rhit-gardneml/Macrophthalmus/Tests/VoltageCONTROLLEDOscilator/vco.jpg

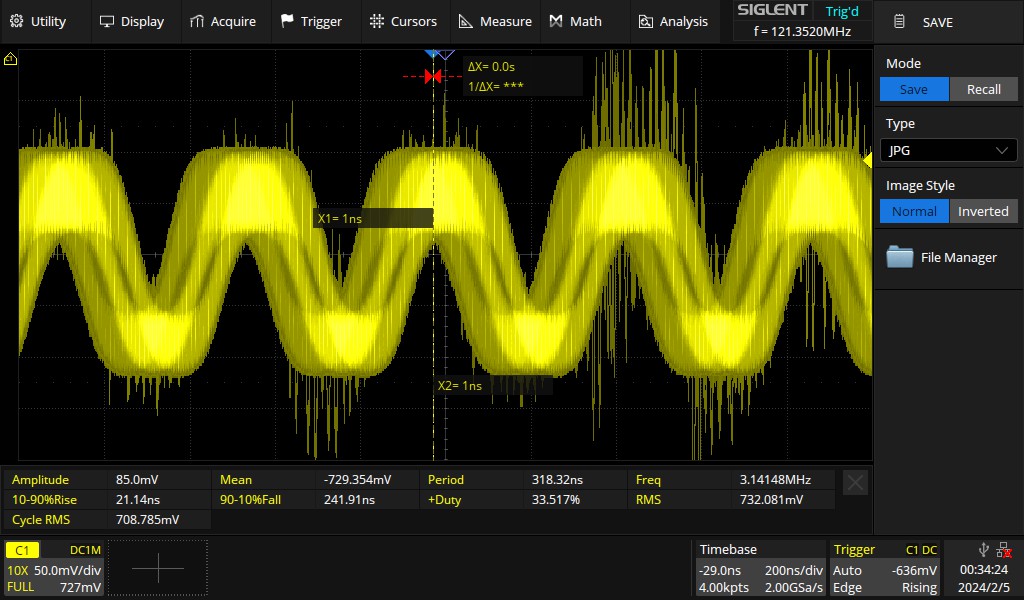
Tests/VoltageCONTROLLEDOscilator/vco.jpg
