rhit-gardneml/Macrophthalmus/Tests/VoltageCONTROLLEDOscilator/vcoeye1.jpg

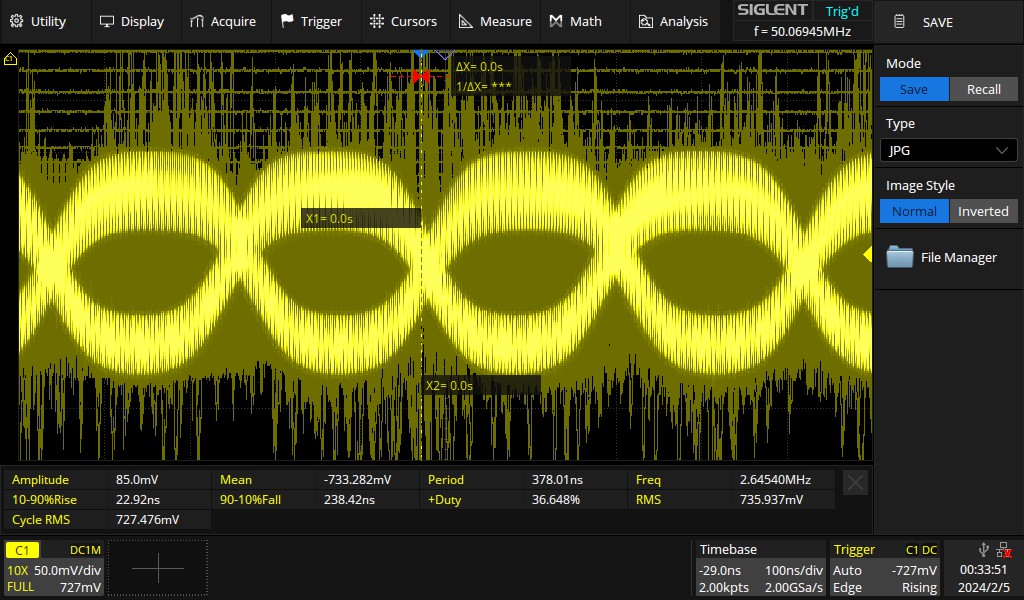
Tests/VoltageCONTROLLEDOscilator/vcoeye1.jpg
