rhit-gardneml/Macrophthalmus/README.md

"# Macrophthalmus"
This is an ece capstone team at rose-hulman makeing a communication module for LEO communication 

Remember to pull before you start working!
