rhit-gardneml/Macrophthalmus/FPGA-Code/UART_FPGA/UARTTypewriter/UartTyperwriter2023fall.runs/impl_1/.init_design.begin.rst

<?xml version="1.0"?>
<ProcessHandle Version="1" Minor="0">
    <Process Command=".planAhead." Owner="hoatsosa" Host="RHIT-R90Y2R7E" Pid="17892">
    </Process>
</ProcessHandle>
