rhit-gardneml/Macrophthalmus/FPGA-Code/QPSK_TxRx/QPSK_TxRx.runs/synth_1/.vivado.begin.rst

<?xml version="1.0"?>
<ProcessHandle Version="1" Minor="0">
    <Process Command="vivado.bat" Owner="lamy1" Host="RHIT-R90Y2R7F" Pid="9360" HostCore="12" HostMemory="016935268352">
    </Process>
</ProcessHandle>
