rhit-gardneml/Macrophthalmus/FPGA-Code/BPSK_modulation/BPSK_modulation/BPSK_modulation.runs/synth_1/.vivado.begin.rst

<?xml version="1.0"?>
<ProcessHandle Version="1" Minor="0">
    <Process Command="vivado.bat" Owner="robinsvs" Host="RHIT-R90Y2R1M" Pid="24328" HostCore="12" HostMemory="016936722432">
    </Process>
</ProcessHandle>
