rhit-gardneml/Macrophthalmus/FPGA-Code/UART_FPGA/UARTTypewriter/UartTyperwriter2023fall.runs/impl_1/.vivado.begin.rst

<?xml version="1.0"?>
<ProcessHandle Version="1" Minor="0">
    <Process Command="vivado.bat" Owner="hoatsosa" Host="RHIT-R90Y2R7E" Pid="26004" HostCore="12" HostMemory="016901607424">
    </Process>
</ProcessHandle>
