rhit-gardneml/Macrophthalmus/VCO/tek00000.png

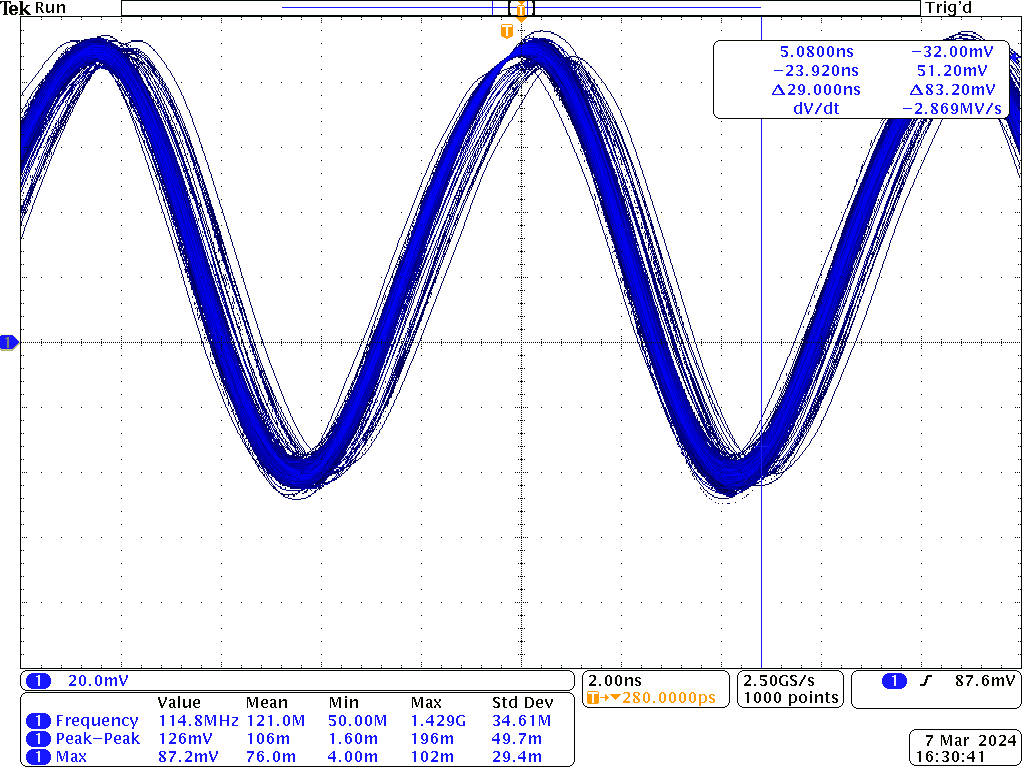
VCO/tek00000.png
