rhit-gardneml/Macrophthalmus/Datasheets and other resources/BOM.xlsx

Sheet: Total BOM
Item | Amount | Link | Part number | Cost | Shipping | Tax | Total Cost | Total
Radiation Hardened 14-Bit 1MSPS SAR ADC | 1 | https://www.renesas.com/us/en/document/dst/isl73141seh-datasheet?r=1399891 | ISL73141SEH | $0.00 |  |  | $0.00 | $1533.42
80MHz Arm M0+ MCU, 128KB Flash, 32KB SRAM, 2×12bit 4Msps ADC, DAC, 3×COMP, 3×op-amp, CAN-FD, MATHACL | 5 | https://www.ti.com/product/MSPM0G3507/part-details/XMSM0G3507SPT | XMSM0G3507SPT | $2.04 | 12 | $0.98 | $23.18
MSPM0G3507 LaunchPad™ development kit for 80-MHz Arm® Cortex®-M0+ MCU | 2 | https://www.ti.com/tool/LP-MSPM0G3507 | LP-MSPM0G3507 | $16.99 | 12 | $2.03 | $48.01
Supervisory Circuits Mil Enh Ultra-Lo Spl Current/Supply Vltg | 3 | https://www.mouser.com/ProductDetail/Texas-Instruments/TPS3106K33MDBVREP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 | TPS3106K33MDBVREP | $5.56 |  |  | $16.68
Conductive, Dissipative Table, Workbench Grounding Mat Rubber Blue 3' (0.91m) X 2' (0.61m) | 1 | https://www.digikey.com/en/products/detail/desco/66322/5822302 | 66322 | $138.53 |  |  | $138.53
Wrist Strap with Cord 6' (1.83m) One Size 1 MOhms Blue | 2 | https://www.digikey.com/en/products/detail/scs/ECWS61M-1/1621640 | ECWS61M-1 | $6.90 |  |  | $13.80
RF Amplifier LOW NOISE AMPL / SM / RoHS | 5 | https://www.mouser.com/ProductDetail/Mini-Circuits/TAV1-331%2b?qs=xZ%2FP%252Ba9zWqaQDud4ssIjbQ%3D%3D | TAV1-331+ | $1.89 |  |  | $9.45
RF Mixer Level 7, SMT High Reliability, RF/LO Freq 300 - 2400 MHz | 5 | https://www.mouser.com/ProductDetail/Mini-Circuits/MAC-24%2B?qs=Imq1NPwxi77%252B9Qt5S4nmTg%3D%3D | MAC-24+ | $33.08 |  |  | $165.40
EVAL BOARD FOR MAC-24+ | 1 | https://www.minicircuits.com/WebStore/dashboard.html?model=MAC-24%2B | TB-MAC-24+ | $146.90 |  |  | $146.90
TEST BOARD FOR TAV1-331+ | 1 | https://www.minicircuits.com/WebStore/dashboard.html?model=TAV1-331%2B | TB-TAV1-331+ | $175.95 |  |  | $175.95
FPGA - Field Programmable Gate Array XA7A100T-1CSG324Q | 4 | https://www.mouser.com/ProductDetail/Xilinx/XA7A100T-1CSG324Q?qs=rrS6PyfT74dDWxqUmFgR8Q%3D%3D | XA7A100T-1CSG324Q | $198.88 |  |  | $795.52
VCO Oscillators BBG ECL Low PWR VCO | 3 | https://www.mouser.com/ProductDetail/onsemi/MC100EL1648DG?qs=sGAEpiMZZMtldj7qu1ydrXz30ua73QtvI4PIjSlVPMs%3D | MC100EL1648DG | $11.89 |  |  | $35.67
 |  |  |  |  |  |  | $0.00
 |  |  |  |  |  |  | $0.00
 |  |  |  |  |  |  | $0.00
 |  |  |  |  |  |  | $0.00
 |  |  |  |  |  |  | $0.00
 |  |  |  |  |  |  | $0.00
 |  |  |  |  |  |  | $0.00
 |  |  |  |  |  |  | $0.00
 |  |  |  |  |  |  | $0.00
 |  |  |  |  |  |  | $0.00
 |  |  |  |  |  |  | $0.00
 |  |  |  |  |  |  | $0.00
 |  |  |  |  |  |  | $0.00
 |  |  |  |  |  |  | $0.00
 |  |  |  |  |  |  | $0.00
 |  |  |  |  |  |  | $0.00
 |  |  |  |  |  |  | $0.00
 |  |  |  |  |  |  | $0.00
 |  |  |  |  |  |  | $0.00
 |  |  |  |  |  |  | $0.00
 |  |  |  |  |  |  | $0.00
 |  |  |  |  |  |  | $0.00
 |  |  |  |  |  |  | $0.00
 |  |  |  |  |  |  | $0.00
 |  |  |  |  |  |  | $0.00
 |  |  |  |  |  |  | $0.00
 |  |  |  |  |  |  | $0.00
 |  |  |  |  |  |  | $0.00
 |  |  |  |  |  |  | $0.00
 |  |  |  |  |  |  | $0.00
 |  |  |  |  |  |  | $0.00
 |  |  |  |  |  |  | $0.00
 |  |  |  |  |  |  | $0.00
 |  |  |  |  |  |  | $0.00
 |  |  |  |  |  |  | $0.00
 |  |  |  |  |  |  | $0.00
 |  |  |  |  |  |  | $0.00
 |  |  |  |  |  |  | $0.00
 |  |  |  |  |  |  | $0.00
 |  |  |  |  |  |  | $0.00
 |  |  |  |  |  |  | $0.00
 |  |  |  |  |  |  | $0.00
 |  |  |  |  |  |  | $0.00
 |  |  |  |  |  |  | $0.00
 |  |  |  |  |  |  | $0.00
 |  |  |  |  |  |  | $0.00
 |  |  |  |  |  |  | $0.00
 |  |  |  |  |  |  | $0.00
 |  |  |  |  |  |  | $0.00
 |  |  |  |  |  |  | $0.00
 |  |  |  |  |  |  | $0.00
 |  |  |  |  |  |  | $0.00
 |  |  |  |  |  |  | $0.00
 |  |  |  |  |  |  | $0.00
 |  |  |  |  |  |  | $0.00
 |  |  |  |  |  |  | $0.00
 |  |  |  |  |  |  | $0.00
 |  |  |  |  |  |  | $0.00
 |  |  |  |  |  |  | $0.00
 |  |  |  |  |  |  | $0.00
 |  |  |  |  |  |  | $0.00
 |  |  |  |  |  |  | $0.00
 |  |  |  |  |  |  | $0.00
 |  |  |  |  |  |  | $0.00
 |  |  |  |  |  |  | $0.00
 |  |  |  |  |  |  | $0.00
 |  |  |  |  |  |  | $0.00
 |  |  |  |  |  |  | $0.00
 |  |  |  |  |  |  | $0.00
 |  |  |  |  |  |  | $0.00
 |  |  |  |  |  |  | $0.00
 |  |  |  |  |  |  | $0.00
 |  |  |  |  |  |  | $0.00
 |  |  |  |  |  |  | $0.00
 |  |  |  |  |  |  | $0.00
 |  |  |  |  |  |  | $0.00
 |  |  |  |  |  |  | $0.00
 |  |  |  |  |  |  | $0.00
 |  |  |  |  |  |  | $0.00
 |  |  |  |  |  |  | $0.00
 |  |  |  |  |  |  | $0.00
 |  |  |  |  |  |  | $0.00
 |  |  |  |  |  |  | $0.00
 |  |  |  |  |  |  | $0.00
 |  |  |  |  |  |  | $0.00
 |  |  |  |  |  |  | $0.00
 |  |  |  |  |  |  | $0.00

Sheet: Tim BOM
Part Description | Quantity | Part URL | Part Number | Unit Price | Total | Total Overall
Supervisory Circuits Mil Enh Ultra-Lo Spl Current/Supply Vltg | 3 | https://www.mouser.com/ProductDetail/Texas-Instruments/TPS3106K33MDBVREP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 | TPS3106K33MDBVREP | $5.56 | $16.68 | $666.71
Conductive, Dissipative Table, Workbench Grounding Mat Rubber Blue 3' (0.91m) X 2' (0.61m) | 1 | https://www.digikey.com/en/products/detail/desco/66322/5822302 | 66322 | $138.53 | $138.53
Wrist Strap with Cord 6' (1.83m) One Size 1 MOhms Blue | 2 | https://www.digikey.com/en/products/detail/scs/ECWS61M-1/1621640 | ECWS61M-1 | $6.90 | $13.80
RF Amplifier LOW NOISE AMPL / SM / RoHS | 5 | https://www.mouser.com/ProductDetail/Mini-Circuits/TAV1-331%2b?qs=xZ%2FP%252Ba9zWqaQDud4ssIjbQ%3D%3D | TAV1-331+ | $1.89 | $9.45
RF Mixer Level 7, SMT High Reliability, RF/LO Freq 300 - 2400 MHz | 5 | https://www.mouser.com/ProductDetail/Mini-Circuits/MAC-24%2B?qs=Imq1NPwxi77%252B9Qt5S4nmTg%3D%3D | MAC-24+ | $33.08 | $165.40
EVAL BOARD FOR MAC-24+ | 1 | https://www.minicircuits.com/WebStore/dashboard.html?model=MAC-24%2B | TB-MAC-24+ | $146.90 | $146.90
TEST BOARD FOR TAV1-331+ | 1 | https://www.minicircuits.com/WebStore/dashboard.html?model=TAV1-331%2B | TB-TAV1-331+ | $175.95 | $175.95
