rhit-gardneml/Macrophthalmus/Eval-Boards/LPF-Eval-Board/EMPCB.SMAFSTJ.B.HT.step

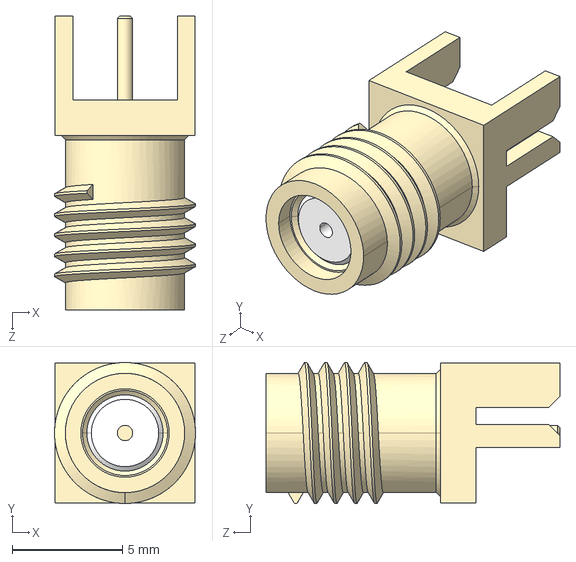
[picture p4: CAD file, 2024-01-26]
Eval-Boards/LPF-Eval-Board/EMPCB.SMAFSTJ.B.HT.step
6.38 x 6.38 x 13.3 mm
