rhit-gardneml/Macrophthalmus/Tests/ADC/DataRateCalculator - March 19.xlsx

Bandwidth / Data rate calculator
 |  |  |  |  | 32000000 | Clock
Desired Throughput | 1200 | Baud
 |  |  |  |  | 48 | Divider | 1, 2, 4, 8, 16, 32, 48
Bandwidth multiplier | 4
 | 4800 | Minimum |  |  | 666666.6667
Required Sample Rate | 5208.333333
 |  |  |  |  | 128 | Hardware downsampling
Bits Per Sample | 12 |  |  |  |  |  | 1, 2, 4, 8, 16, 32, 64, 128
 |  |  |  |  | 5208.333333 | Sample Rate
Bytes Per Sample | 2 |  |  |  | 0.0001920000 | Seconds
 |  |  |  |  | 2604.166667 | Highest Frequency Capture
Data rate | 10416.66667 | bytes per second
 |  |  |  |  | 17.8 | mS | 0.05617977528
Data rate | 83333.33333 | bits per second |  |  | 0.017800 | uS | 56.17977528
 |  |  |  |  | 9.270833333e-05
Conversion bps to baud | 0.80
 |  |  |  |  | 128 | ping
Baud to FPGA | 104166.6667 |  |  |  | 128 | pong
 | 115200 | Baud |  |  | 256 |  | 98 | ms
 | 0.0000086806 |  |  |  | 0.0492 | seconds | 3.8 | seconds
 | 0.0000868056 | 0.02222 | s | 0.01111111111 | 0.0246
 |  | 22.22222222 | ms | 11.11111111
 | 50 | uS |  |  | 0.000015729
 | 50000 | mS |  |  | 0.0157286
 | 50000000 | S
