rhit-gardneml/Macrophthalmus/Tests/ADC/DataRateCalculator.xlsx

Bandwidth / Data rate calculator
 |  |  | 32000000 | Clock
Desired Throughput | 1200 | Baud
 |  |  | 48 | Divider | 1, 2, 4, 8, 16, 32, 48
Bandwidth multiplier | 4
 | 4800 | Minimum | 666666.6667
Required Sample Rate | 5208.333333
 |  |  | 128 | Hardware downsampling
Bits Per Sample | 12 |  |  |  | 1, 2, 4, 8, 16, 32, 64, 128
 |  |  | 5208.333333 | Sample Rate
Bytes Per Sample | 2
Data rate | 10416.66667 | bytes per second
Data rate | 83333.33333 | bits per second
Conversion bps to baud | 0.80
Baud to FPGA | 104166.6667
 | 115200 | Baud
