rhit-gardneml/Macrophthalmus/Tests/Mixer/Downsample/GoodLunch.pdf

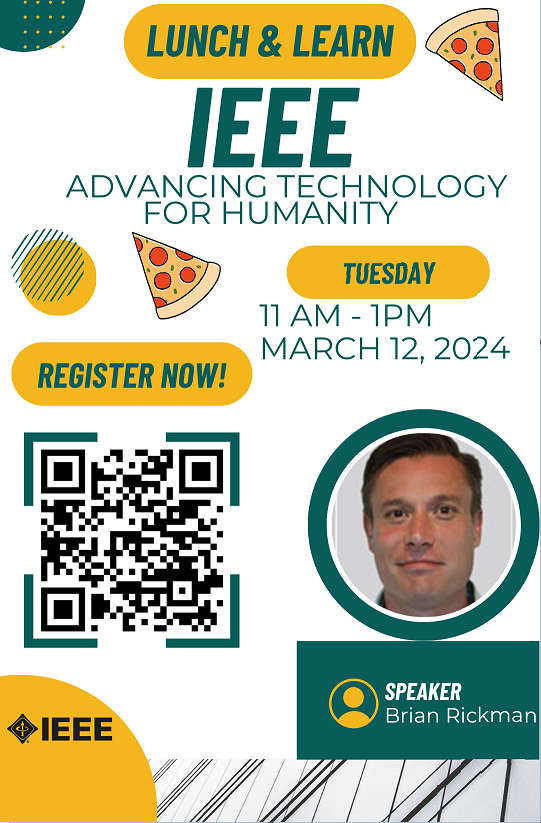
[picture p5: figure]
