rhit-gardneml/Macrophthalmus/Tests/Mar22nd/PA-Test.xlsx

Freq (MHz) | dBm before | dBm After
400 | -37 | -23
410 | -40 | -19
420 | -41 | -18
430 | -42 | -17 | 430MHz | -50
440 | -53 | -18
450 | -56 | -18
460 | -52 | -22
