rhit-gardneml/Macrophthalmus/Tests/Mixer_with_BPF/Data.xlsx

Freq in | Freq out | Freq Diff | Harm | Harm Diff | dBm in | dBm out | dBm harm | dBm diff
400 | 402 | 2 | 800 | 398 | 2.3 | -55 | -65 | -10
405 | 407 | 2 | 810 | 403 | 2.3 | -50 | -64 | -14
410 | 412 | 2 | 820 | 408 | 2.3 | -55 | -65 | -10
415 | 417 | 2 | 830 | 413 | 2.3 | -55 | -69 | -14
420 | 422 | 2 | 840 | 418 | 2.3 | -51 | -70 | -19
425 | 427 | 2 | 850 | 423 | 2.3 | -49 | -70 | -21
429 | 431 | 2 | 859 | 428 | 2.3 | -52 | -75 | -23
430 | 432 | 2 | 860 | 428 | 2.3 | -55 | -69 | -14 | *Tori Take in data and add 20 to dB
435 | 437 | 2 | 870 | 433 | 2.3 | -57 | -73 | -16
440 | 442 | 2 | 880 | 438 | 2.3 | -49 | -70 | -21
445 | 447 | 2 | 890 | 443 | 2.3 | -56 | -71 | -15
450 | 452 | 2 | 900 | 448 | 2.3 | -60 | -70 | -10
455 | 457 | 2 | 910 | 453 | 2.3 | -63 | -70 | -7
 | 800 |  |  |  |  | -65
 | 810 |  |  |  |  | -64
 | 820 |  |  |  |  | -65
 | 830 |  |  |  |  | -69
 | 840 |  |  |  |  | -70
 | 850 |  |  |  |  | -70
 | 859 |  |  |  |  | -75
 | 860 |  |  |  |  | -69
 | 870 |  |  |  |  | -73
 | 880 |  |  |  |  | -70
 | 890 |  |  |  |  | -71
 | 900 |  |  |  |  | -70
 | 910 |  |  |  |  | -70
