rhit-gardneml/Macrophthalmus/Tests/DAC/BPSK_Digital_Representation - March 19.xlsx

 | samples | time | freq | bpsk | digital1 |  | samples | time | freq | bpsk | digital0
BPSK "1" | 0 | 1e-05 | 8000 | 0.87631 | 3841.737927 | BPSK "0" | 0 | 1e-06 | 80000 | -0.9 | 204.75
1e-05 | 1 | 2e-05 | 8000 | 0.53583 | 3144.605353 |  | 1 | 2e-06 | 80000 | -0.5 | 1023.75
1e-05 | 2 | 3e-05 | 8000 | 0.06279 | 2176.06359 |  | 2 | 3e-06 | 80000 | -0.1 | 1842.75
1e-05 | 3 | 4e-05 | 8000 | -0.42578 | 1175.716904 |  | 3 | 4e-06 | 80000 | 0.4 | 2866.5
1e-05 | 4 | 5e-05 | 8000 | -0.80902 | 391.037713 |  | 4 | 5e-06 | 80000 | 0.8 | 3685.5
1e-05 | 5 | 6e-05 | 8000 | -0.99211 | 16.14515175 |  | 5 | 6e-06 | 80000 | 1.0 | 4095
1e-05 | 6 | 7e-05 | 8000 | -0.92978 | 143.7826367 |  | 6 | 7e-06 | 80000 | 0.9 | 3890.25
1e-05 | 7 | 8e-05 | 8000 | -0.63742 | 742.3743805 |  | 7 | 8e-06 | 80000 | 0.6 | 3276
1e-05 | 8 | 9e-05 | 8000 | -0.18738 | 1663.836768 |  | 8 | 9e-06 | 80000 | 0.2 | 2457
1e-05 | 9 | 0.0001 | 8000 | 0.30902 | 2680.212287 |  | 9 | 1e-05 | 80000 | -0.3 | 1433.25
1e-05 | 10 | 0.00011 | 8000 | 0.72897 | 3540.06327 |  | 10 | 1.1e-05 | 80000 | -0.7 | 614.25
1e-05 | 11 | 0.00012 | 8000 | 0.96858 | 4030.67402 |  | 11 | 1.2e-05 | 80000 | -1.0 | 0
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
