rhit-gardneml/Macrophthalmus/Tests/NewLowPass/LowPassTest.xlsx

Input Frequency | Input dBm | Output Frequency | Output dBm | Highest Harmonic | Output dBm
10000 | 3.98 | 10000 | 3.3 | 24000 | -60
20000 | 3.98 | 20000 | 3.8 | 60000 | -60
100000 | 3.98 | 100000 | 4.1 | 900000 | -75
500000 | 3.98 | 500000 | 4 | 3500000 | -70
1000000 | 0 | 1000000 | -0.3 | 300000000 | -75
2000000 | 0 | 2000000 | -0.2 | 0 | 0
3000000 | 0 | 3000000 | -0.6 | 0 | 0
4000000 | 0 | 4000000 | -12.9 | 0 | 0
5000000 | 0 | 5000000 | -42.2 | 0 | 0
10000000 | 0 | 10000000 | -58.9 | 0 | 0
