rhit-gardneml/Macrophthalmus/Tests/DAC/BPSK_Digital_Representation.xlsx

 | samples | time | freq | bpsk | digital1 |  | samples | time | freq | bpsk | digital0
BPSK "1" | 0 | 1e-06 | 20000 | 0.9921151658 | 4078.855802 | BPSK "0" | 0 | 1e-06 | 20000 | -0.9921151658 | 16.144198
 | 1 | 2e-06 | 20000 | 0.9685850045 | 4030.677797 |  | 1 | 2e-06 | 20000 | -0.9685850045 | 64.32220336
 | 2 | 3e-06 | 20000 | 0.9297805788 | 3951.225735 |  | 2 | 3e-06 | 20000 | -0.9297805788 | 143.7742649
 | 3 | 4e-06 | 20000 | 0.8763138217 | 3841.75255 |  | 3 | 4e-06 | 20000 | -0.8763138217 | 253.24745
 | 4 | 5e-06 | 20000 | 0.8090278863 | 3703.984597 |  | 4 | 5e-06 | 20000 | -0.8090278863 | 391.0154028
 | 5 | 6e-06 | 20000 | 0.7289838494 | 3540.094432 |  | 5 | 6e-06 | 20000 | -0.7289838494 | 554.9055683
 | 6 | 7e-06 | 20000 | 0.637443979 | 3352.666547 |  | 6 | 7e-06 | 20000 | -0.637443979 | 742.3334531
 | 7 | 8e-06 | 20000 | 0.5358518283 | 3144.656619 |  | 7 | 8e-06 | 20000 | -0.5358518283 | 950.3433815
 | 8 | 9e-06 | 20000 | 0.4258094721 | 2919.344894 |  | 8 | 9e-06 | 20000 | -0.4258094721 | 1175.655106
 | 9 | 1e-05 | 20000 | 0.3090522417 | 2680.284465 |  | 9 | 1e-05 | 20000 | -0.3090522417 | 1414.715535
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
