rhit-gardneml/Macrophthalmus/Tests/Mixer/Upsample/Up_Conversion_Data_mk1.xlsx

Freq in | Freq out | Freq Diff | Abs Harm BW | Harm BW | dBm in | dBm out
400 | 402 | 2 | 801 | 399 | 2.3 | -47
405 | 407 | 2 | 810 | 403 | 2.3 | -44
410 | 412 | 2 | 820 | 408 | 2.3 | -48
415 | 417 | 2 | 830 | 413 | 2.3 | -46
420 | 422 | 2 | 840 | 418 | 2.3 | -44
425 | 427 | 2 | 850 | 423 | 2.3 | -41
429 | 431 | 2 | 858 | 427 | 2.3 | -42
430 | 432 | 2 | 860 | 428 | 2.3 | -45
435 | 437 | 2 | 870 | 433 | 2.3 | -42
440 | 442 | 2 | 880 | 438 | 2.3 | -41
445 | 447 | 2 | 890 | 443 | 2.3 | -45
450 | 452 | 2 | 900 | 448 | 2.3 | -42
455 | 457 | 2 | 910 | 453 | 2.3 | -41
