rhit-gardneml/Macrophthalmus/Tests/ADC/Correct/ADC_DMA_Period.png

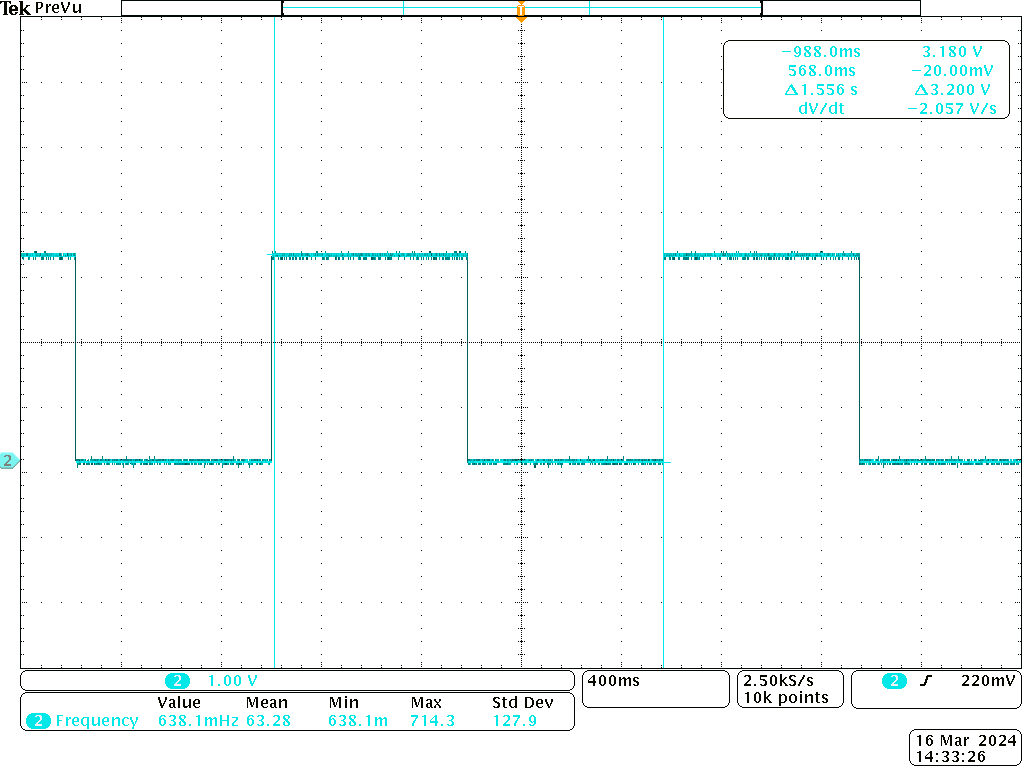
Tests/ADC/Correct/ADC_DMA_Period.png
