rhit-gardneml/Macrophthalmus/Tests/ADC/Correct/ADC_DMA_UART_Transfer.png

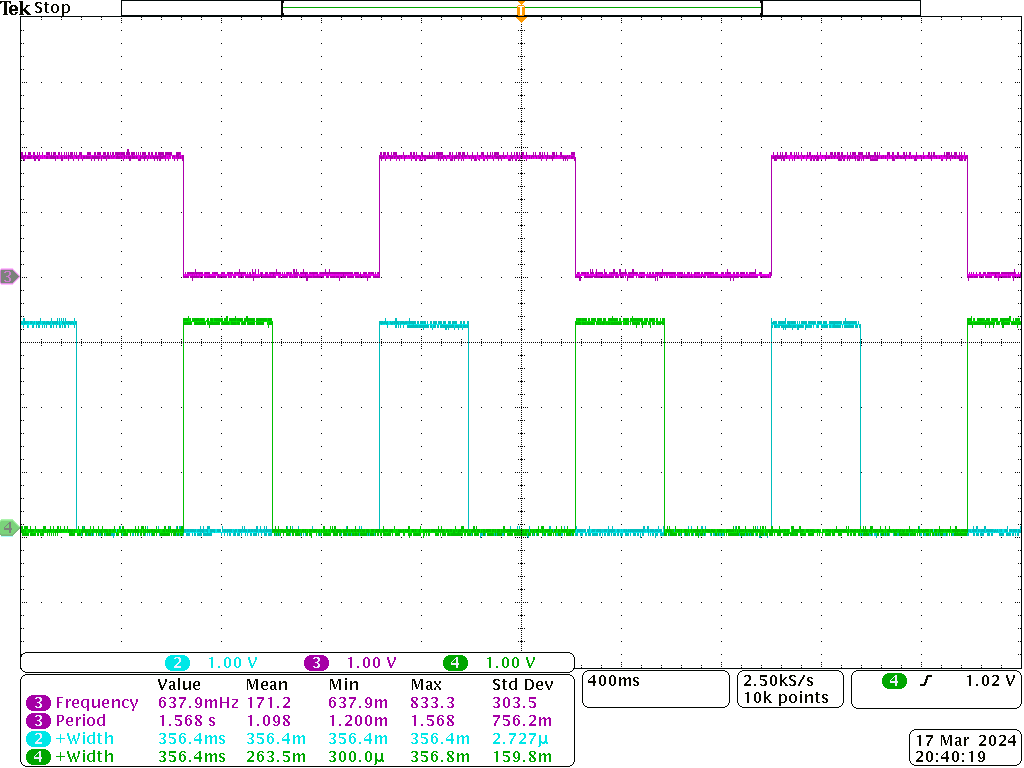
Tests/ADC/Correct/ADC_DMA_UART_Transfer.png
