rhit-gardneml/Macrophthalmus/Tests/ADC/Correct/ADC_DMA_UART_transfer_128_closeup.png

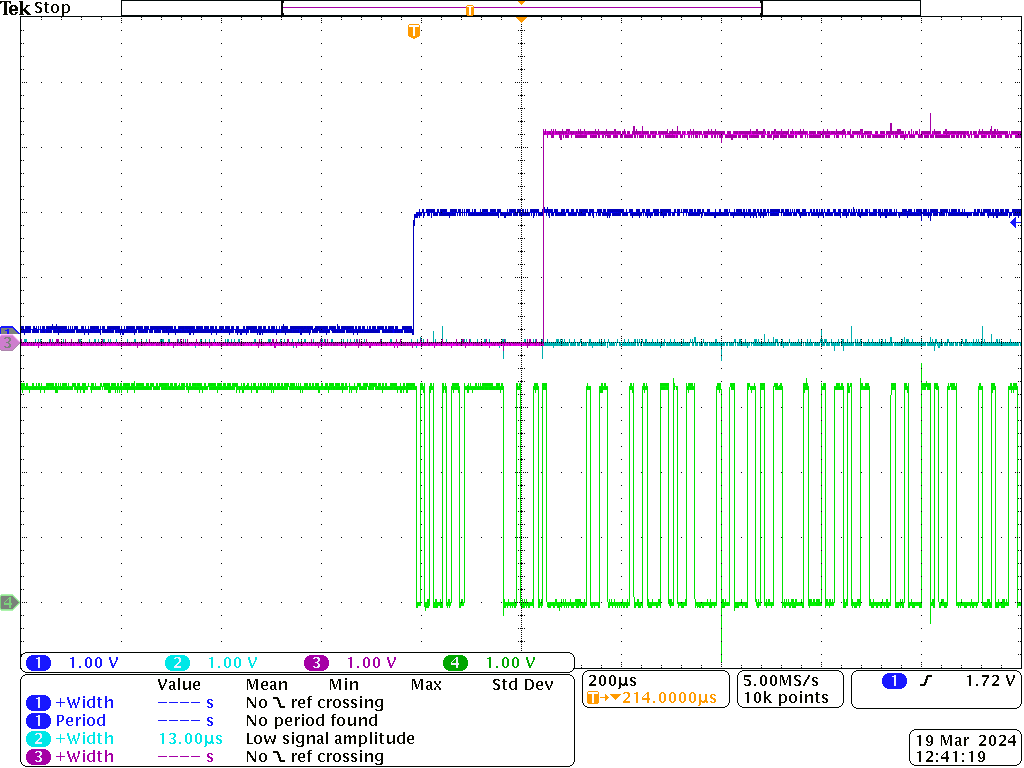
Tests/ADC/Correct/ADC_DMA_UART_transfer_128_closeup.png
