rhit-gardneml/Macrophthalmus/Tests/ADC/Correct/ADC_DMA_UART_Transfer_128samples.png

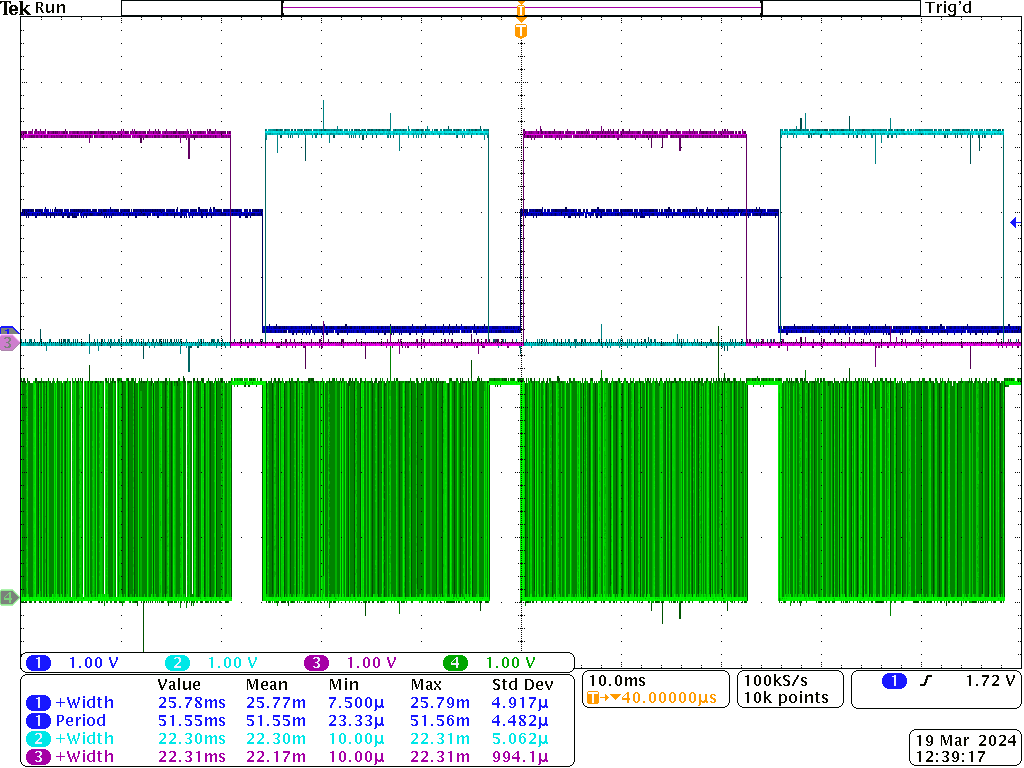
Tests/ADC/Correct/ADC_DMA_UART_Transfer_128samples.png
