rhit-gardneml/Macrophthalmus/Tests/ADC/Incorrect/ADC_1MHz^PSK.png

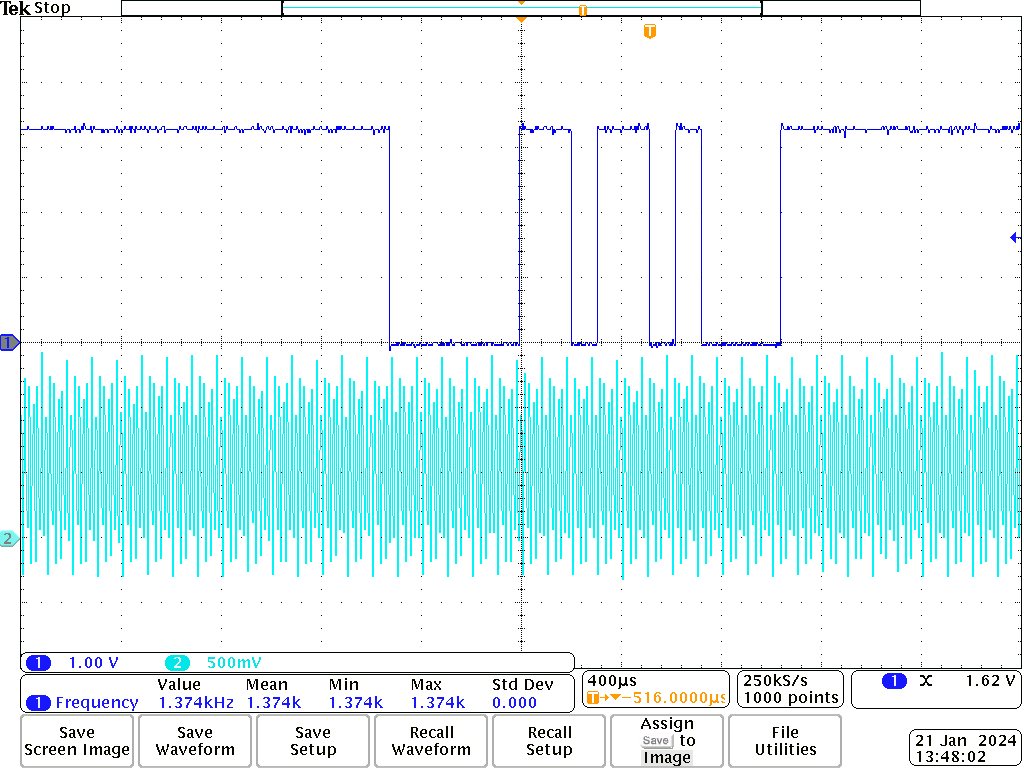
Tests/ADC/Incorrect/ADC_1MHz^PSK.png
