rhit-gardneml/Macrophthalmus/Tests/ADC/Incorrect/tek00066.png

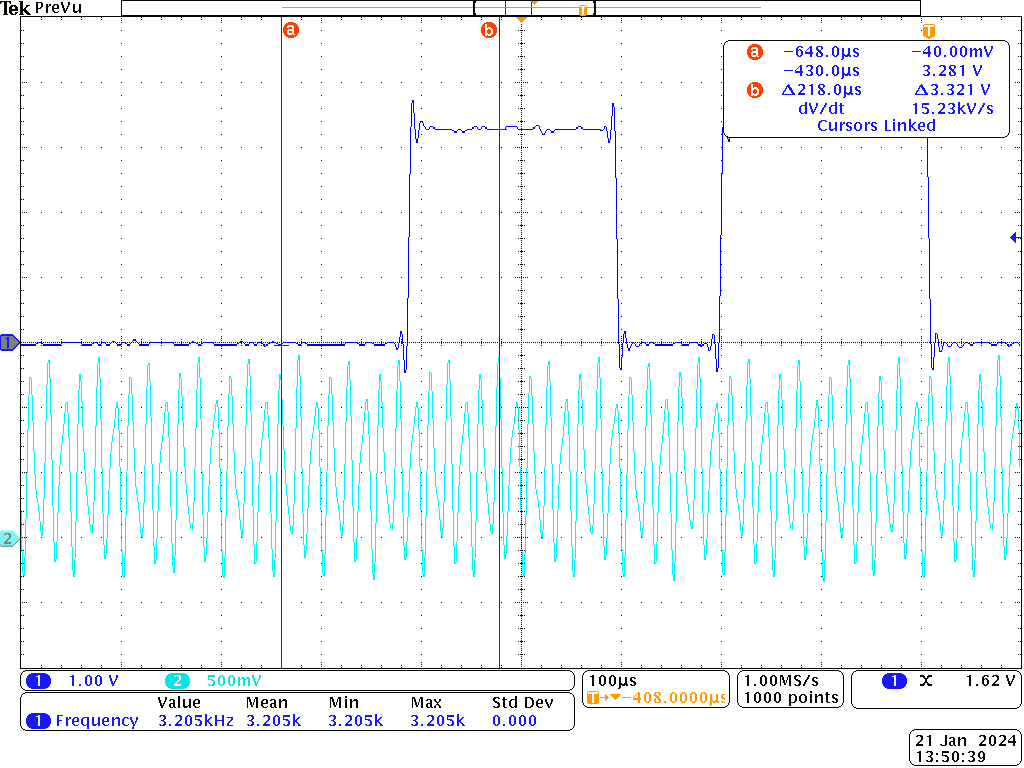
Tests/ADC/Incorrect/tek00066.png
