rhit-gardneml/Macrophthalmus/Tests/ADC/Incorrect/tek00067.png

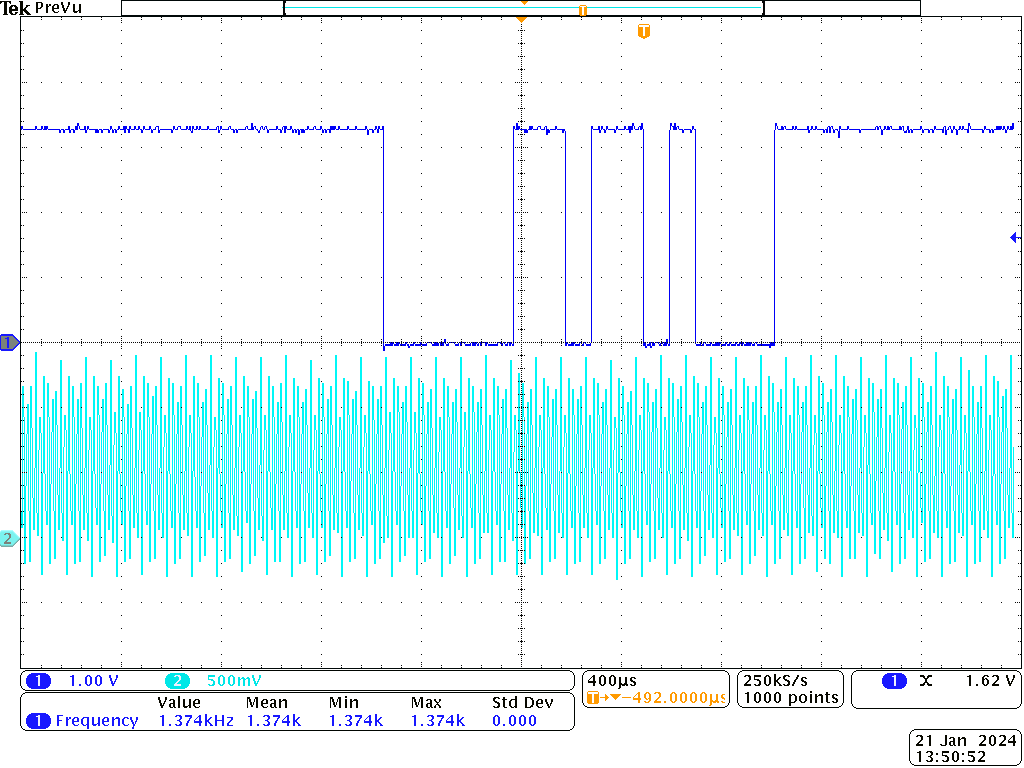
Tests/ADC/Incorrect/tek00067.png
