rhit-gardneml/Macrophthalmus/Tests/ADC/Incorrect/tek00068.png

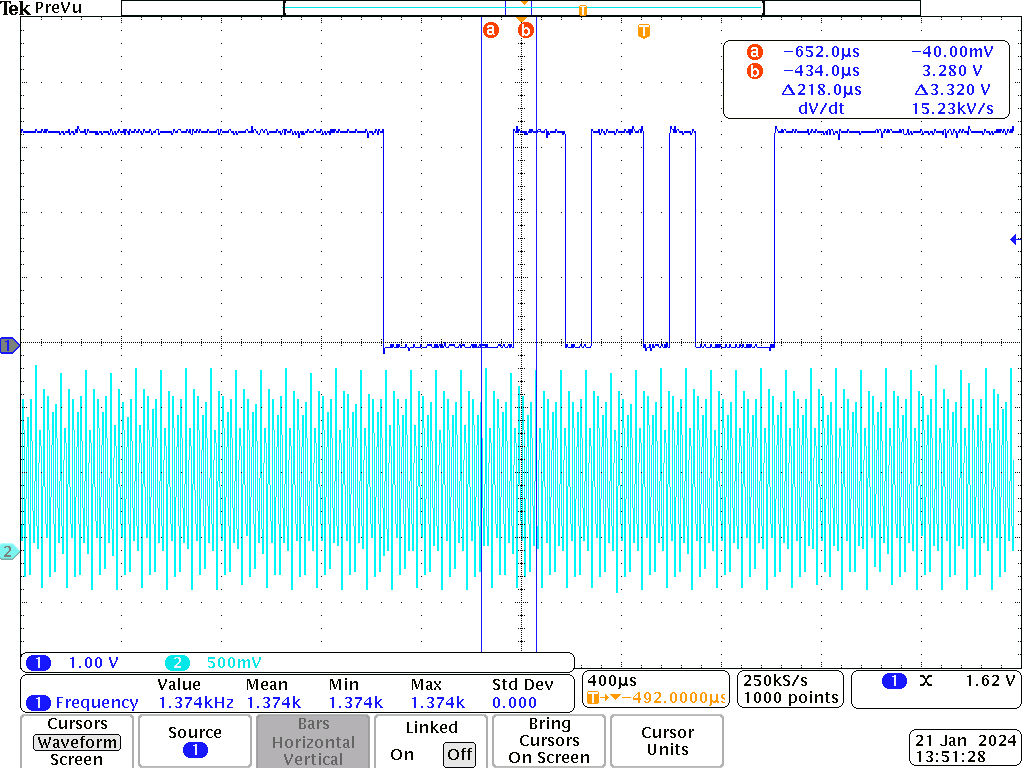
Tests/ADC/Incorrect/tek00068.png
