rhit-gardneml/Macrophthalmus/Tests/DAC/DAC100k.png

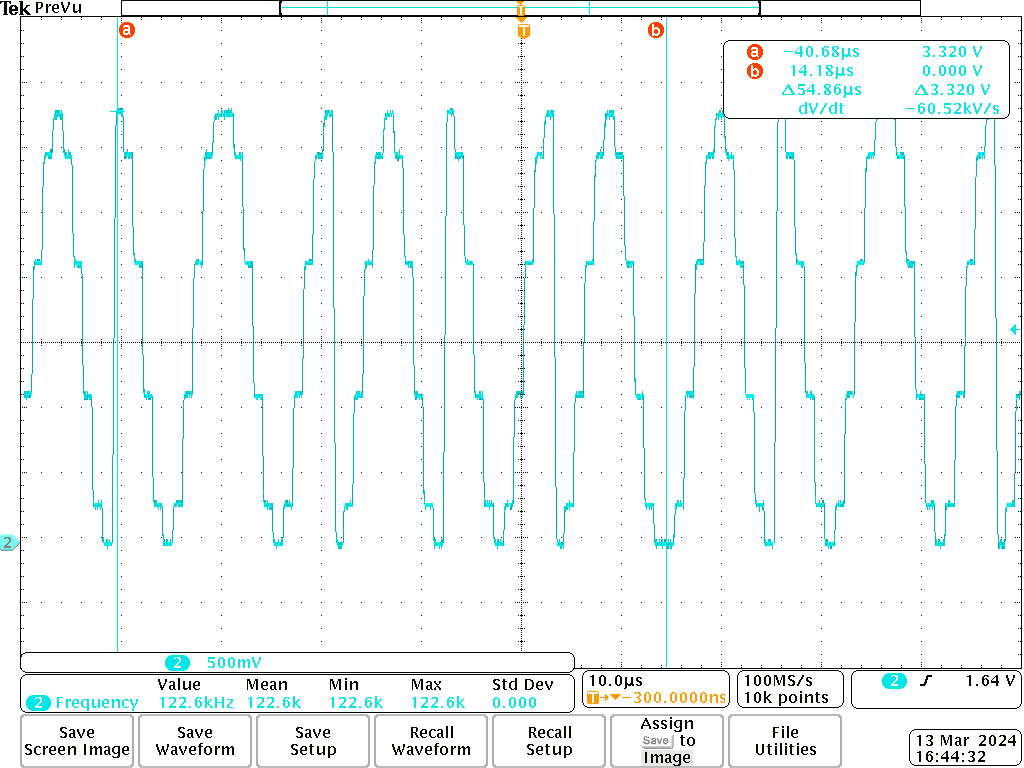
Tests/DAC/DAC100k.png
