rhit-gardneml/Macrophthalmus/Tests/Mar16th/tek00000.png

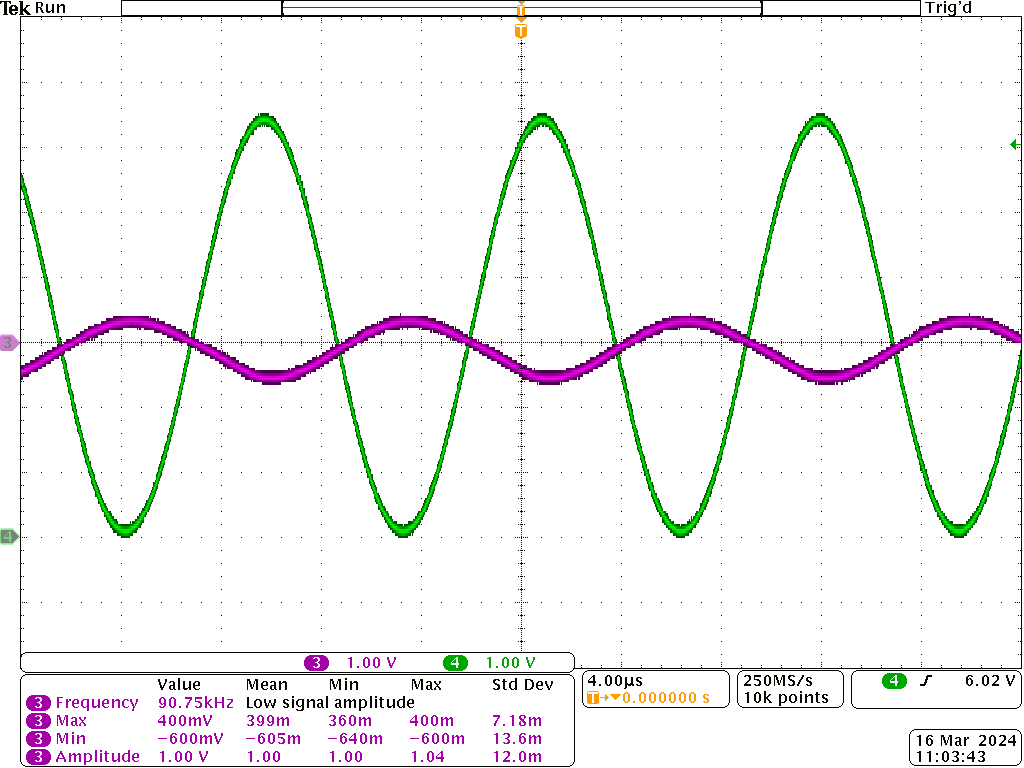
Tests/Mar16th/tek00000.png
