rhit-gardneml/Macrophthalmus/Tests/Mar16th/tek00001.png

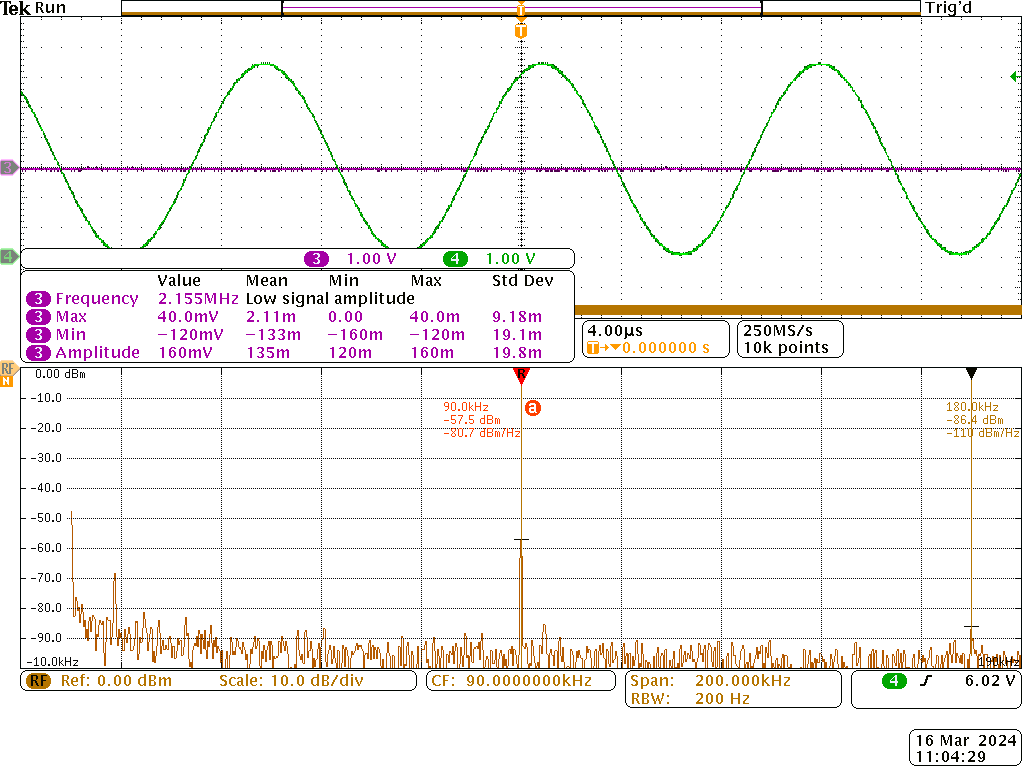
Tests/Mar16th/tek00001.png
