rhit-gardneml/Macrophthalmus/Tests/Mar16th/tek00002.png

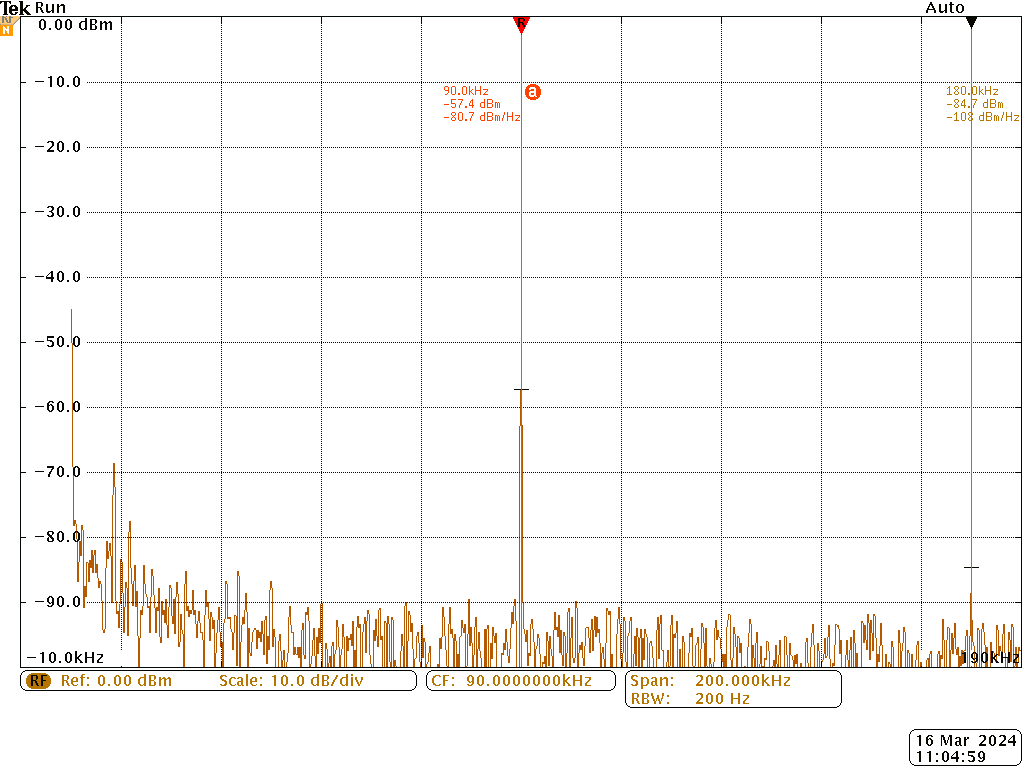
Tests/Mar16th/tek00002.png
