rhit-gardneml/Macrophthalmus/Tests/Mar16th/tek00003.png

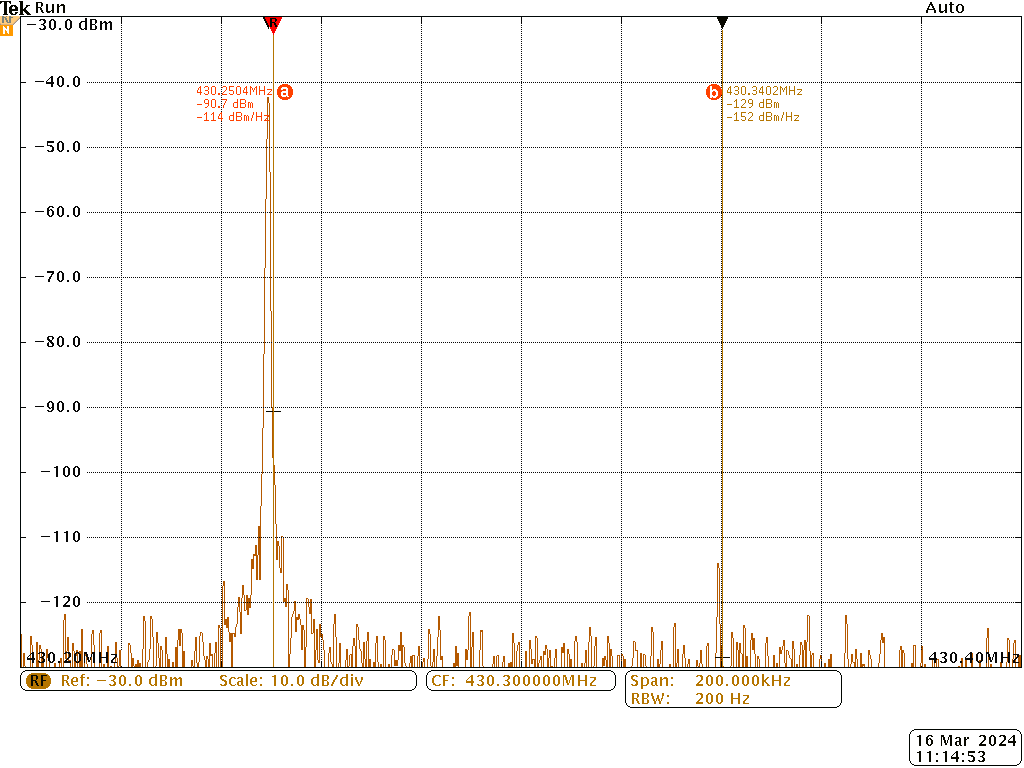
Tests/Mar16th/tek00003.png
