rhit-gardneml/Macrophthalmus/Tests/Mar16th/tek00006.png

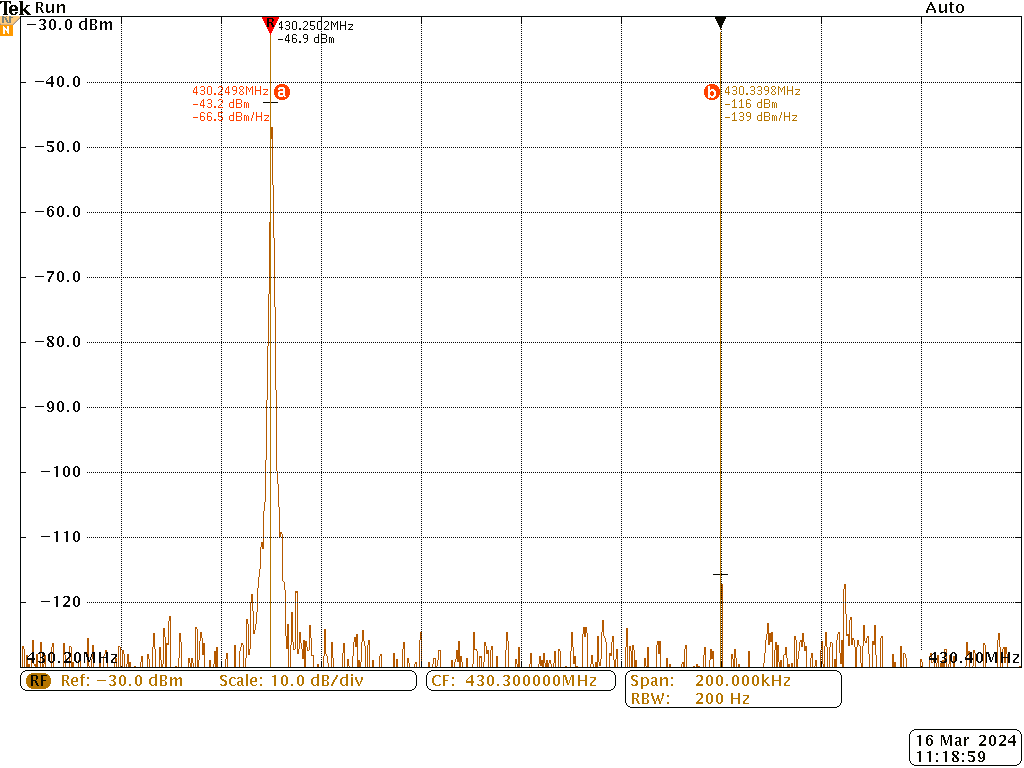
Tests/Mar16th/tek00006.png
