rhit-gardneml/Macrophthalmus/Tests/Mar16th/tek00007.png

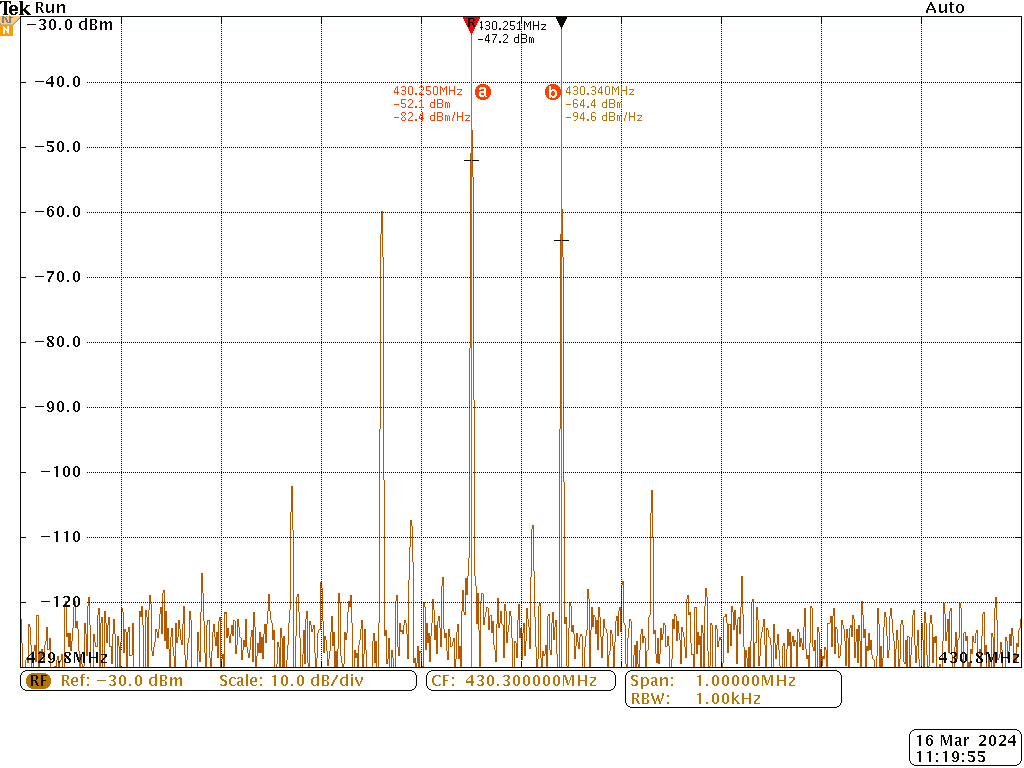
Tests/Mar16th/tek00007.png
