rhit-gardneml/Macrophthalmus/Tests/Mar16th/tek00008.png

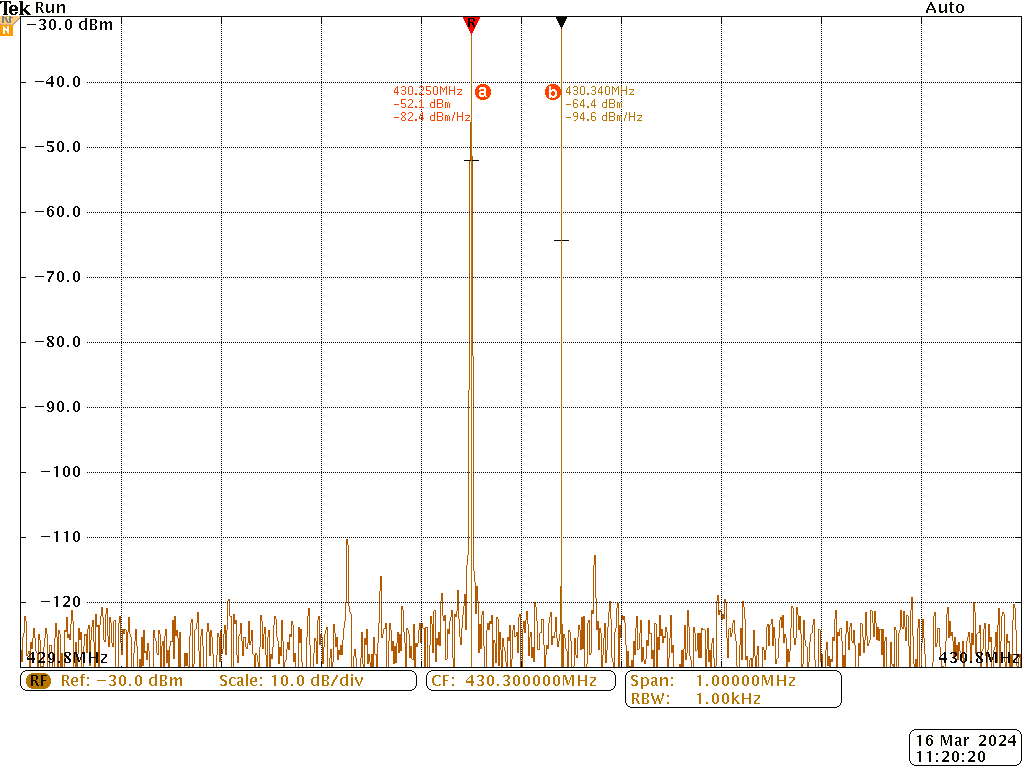
Tests/Mar16th/tek00008.png
