rhit-gardneml/Macrophthalmus/Tests/Mar16th/tek00009.png

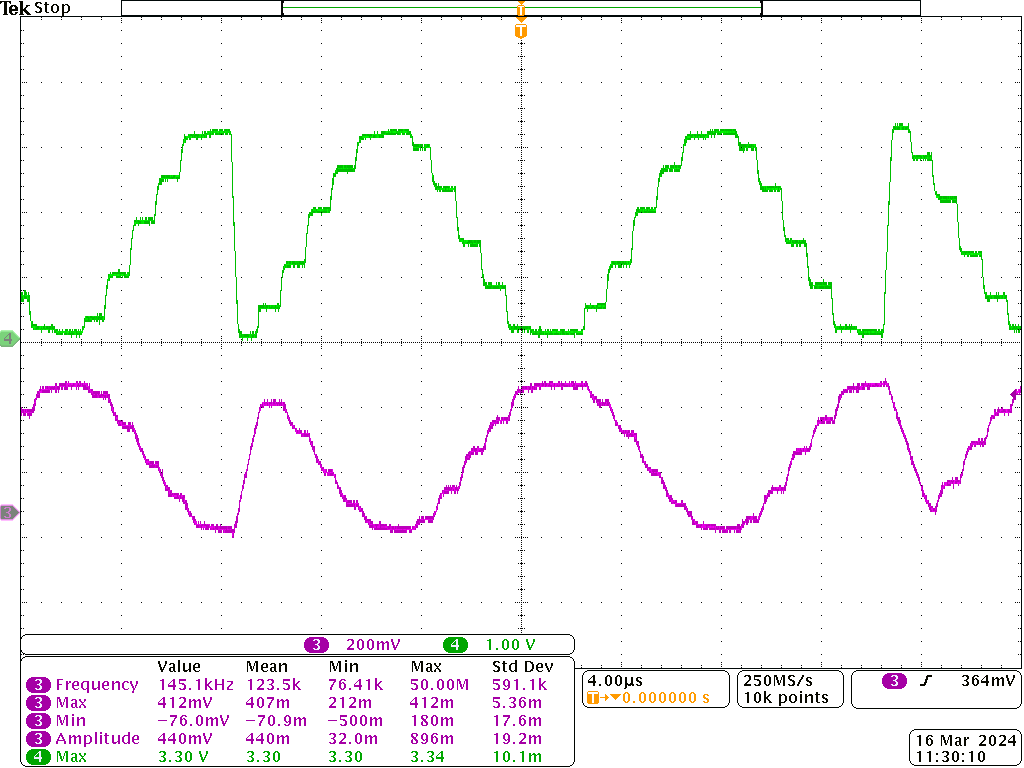
Tests/Mar16th/tek00009.png
