rhit-gardneml/Macrophthalmus/Tests/Mar16th/tek00010.png

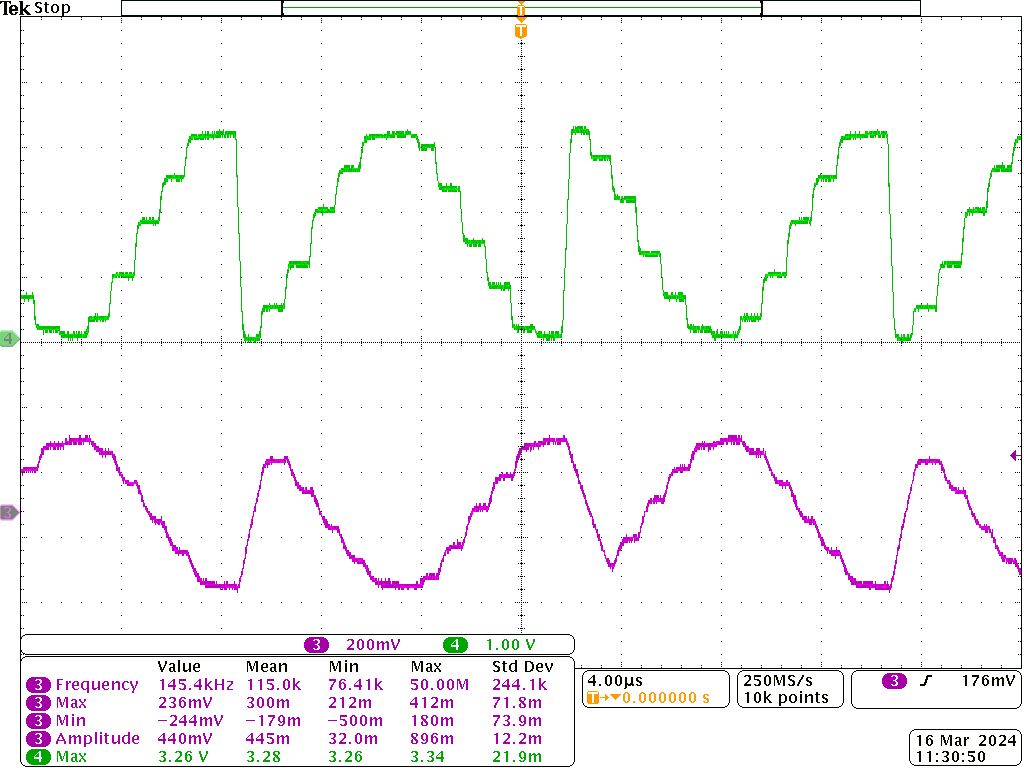
Tests/Mar16th/tek00010.png
