rhit-gardneml/Macrophthalmus/Tests/Mar16th/tek00011.png

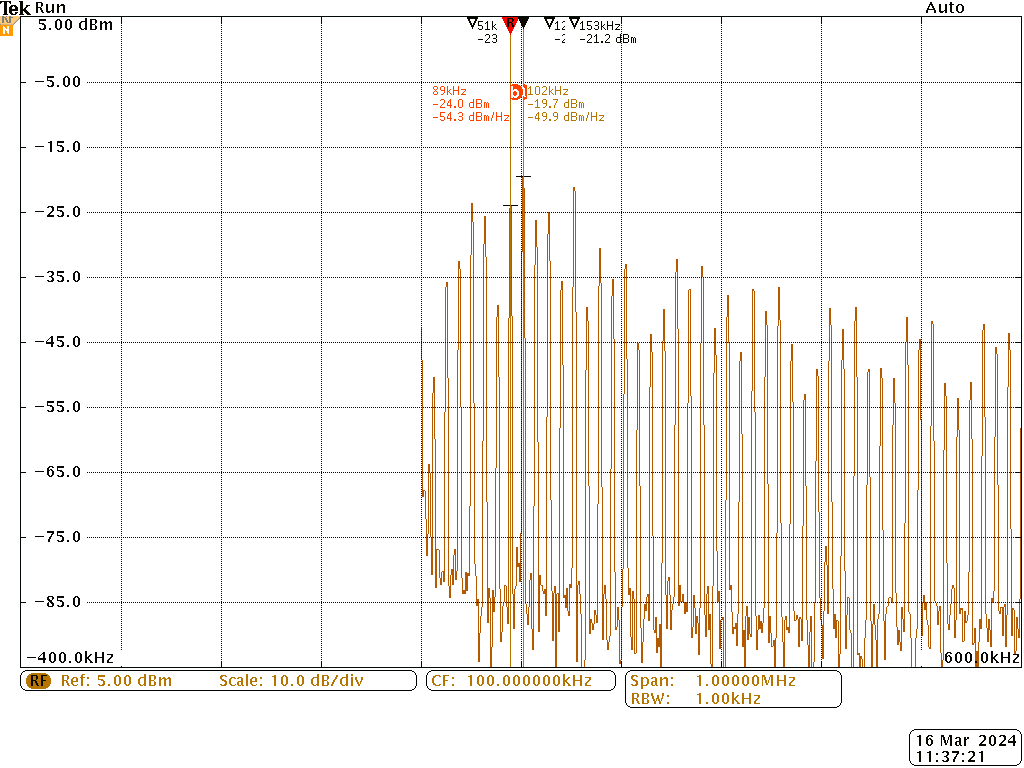
Tests/Mar16th/tek00011.png
