rhit-gardneml/Macrophthalmus/Tests/Mar16th/tek00012.png

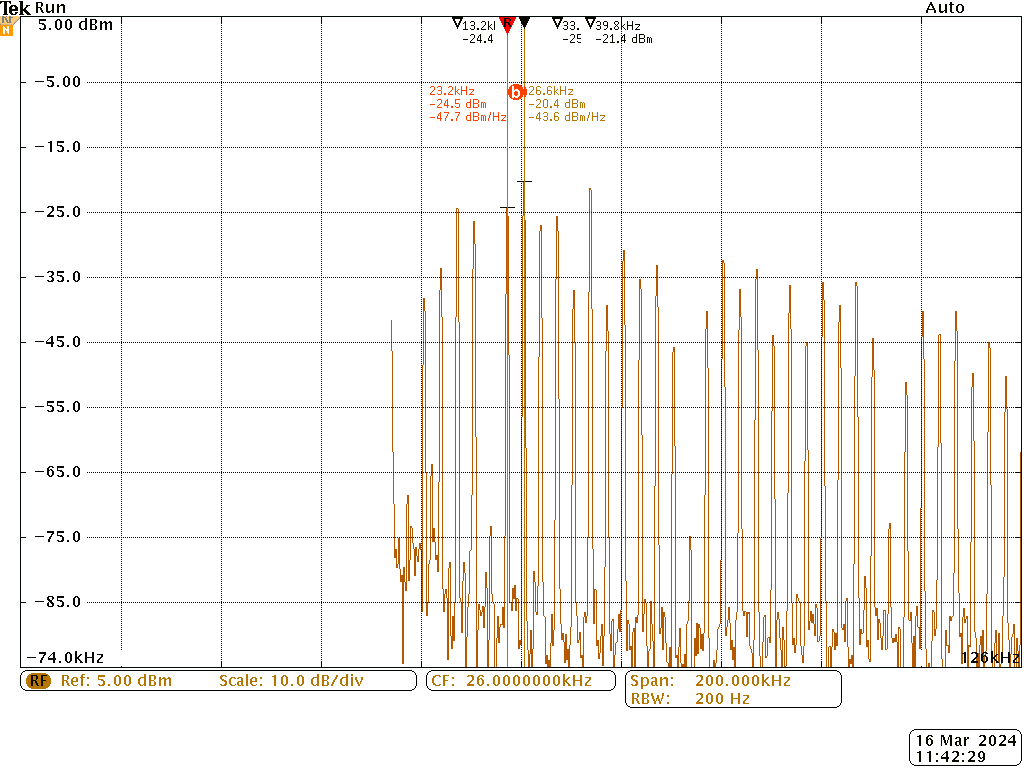
Tests/Mar16th/tek00012.png
