rhit-gardneml/Macrophthalmus/Tests/Mar16th/tek00013.png

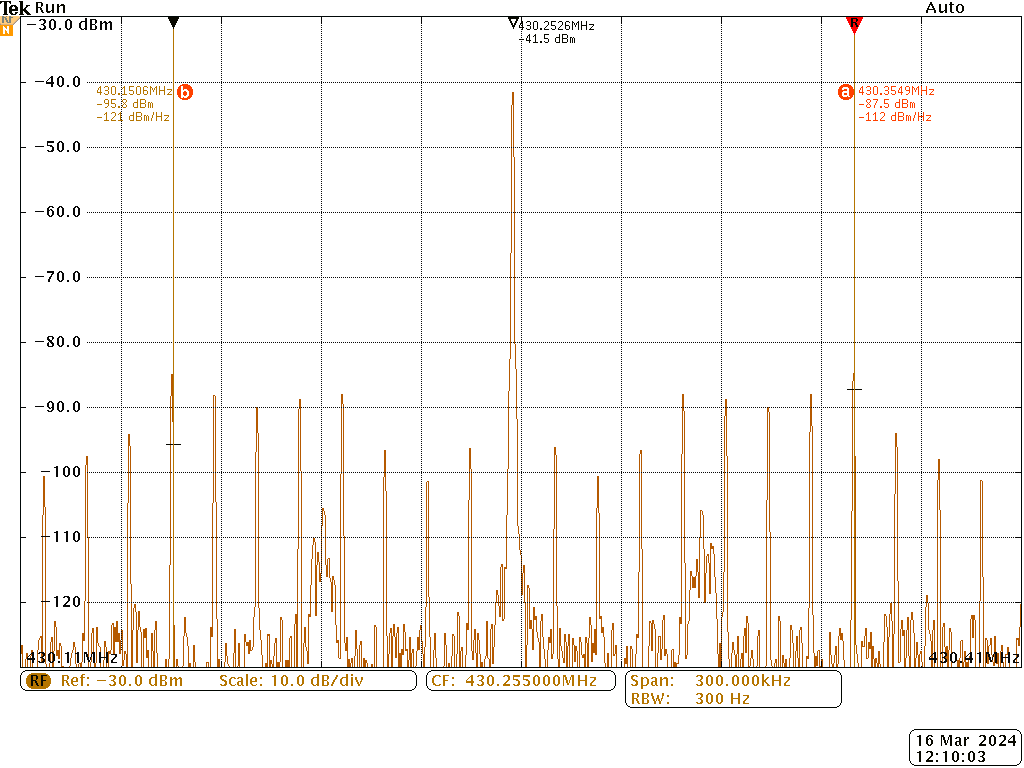
Tests/Mar16th/tek00013.png
