rhit-gardneml/Macrophthalmus/Tests/Mar16th/tek00014.png

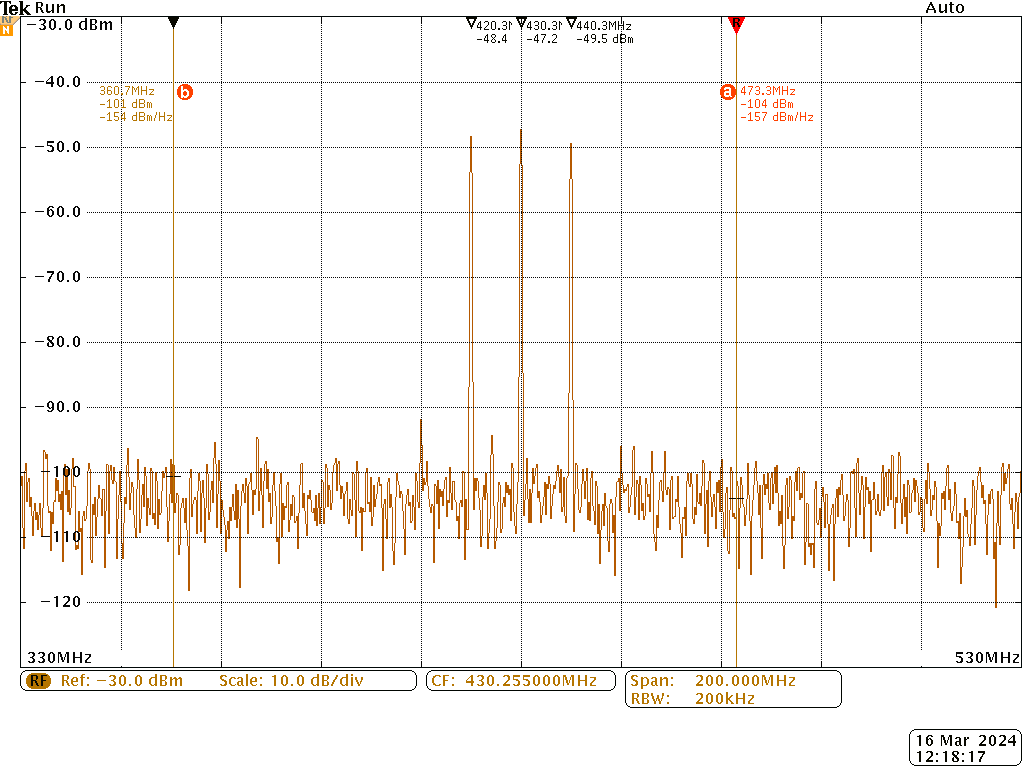
Tests/Mar16th/tek00014.png
