rhit-gardneml/Macrophthalmus/Tests/Mar16th/tek00015.png

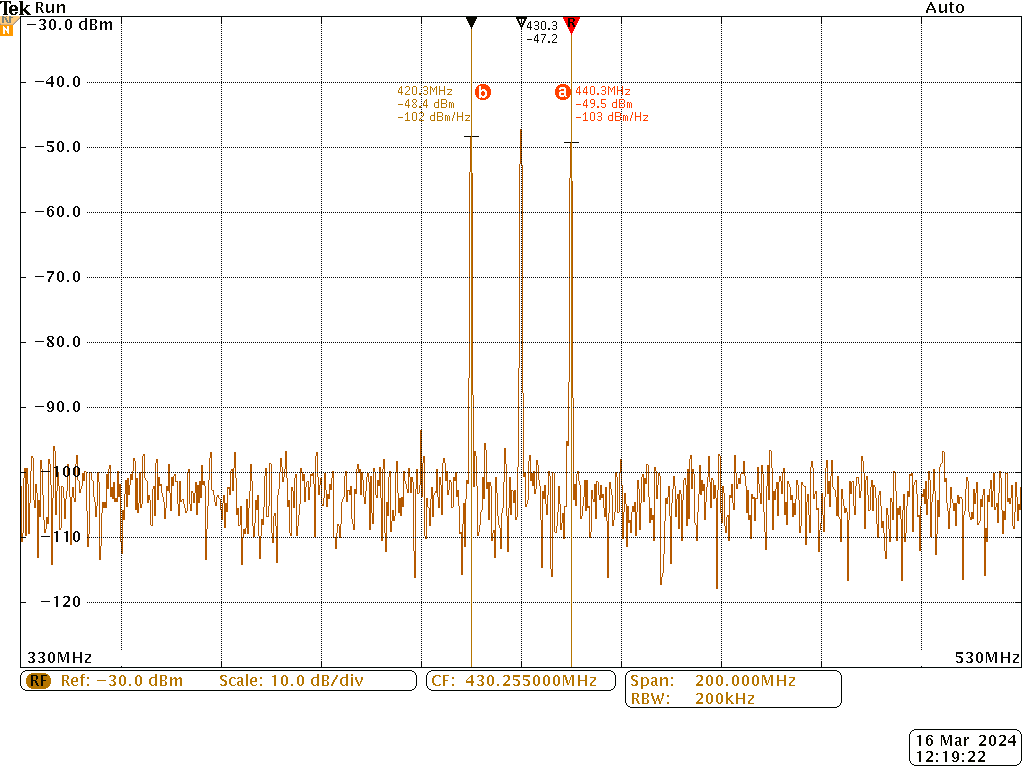
Tests/Mar16th/tek00015.png
