rhit-gardneml/Macrophthalmus/Tests/Mar16th/tek00016.png

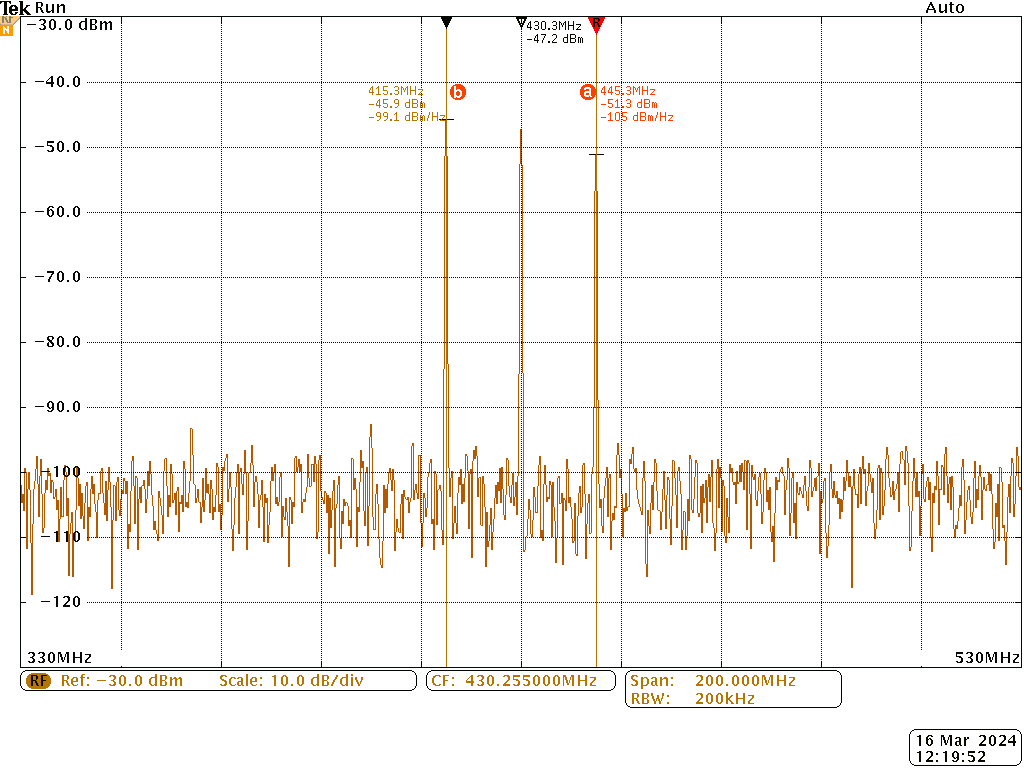
Tests/Mar16th/tek00016.png
