rhit-gardneml/Macrophthalmus/Tests/Mar16th/tek00017.png

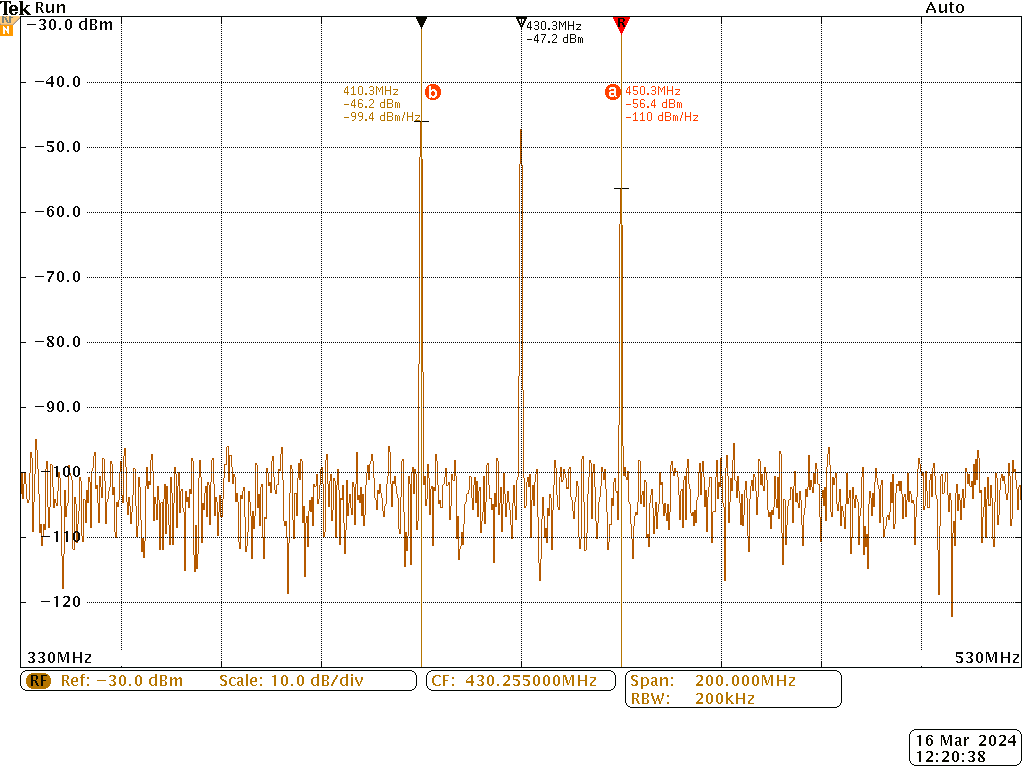
Tests/Mar16th/tek00017.png
