rhit-gardneml/Macrophthalmus/Tests/Mar16th/tek00018.png

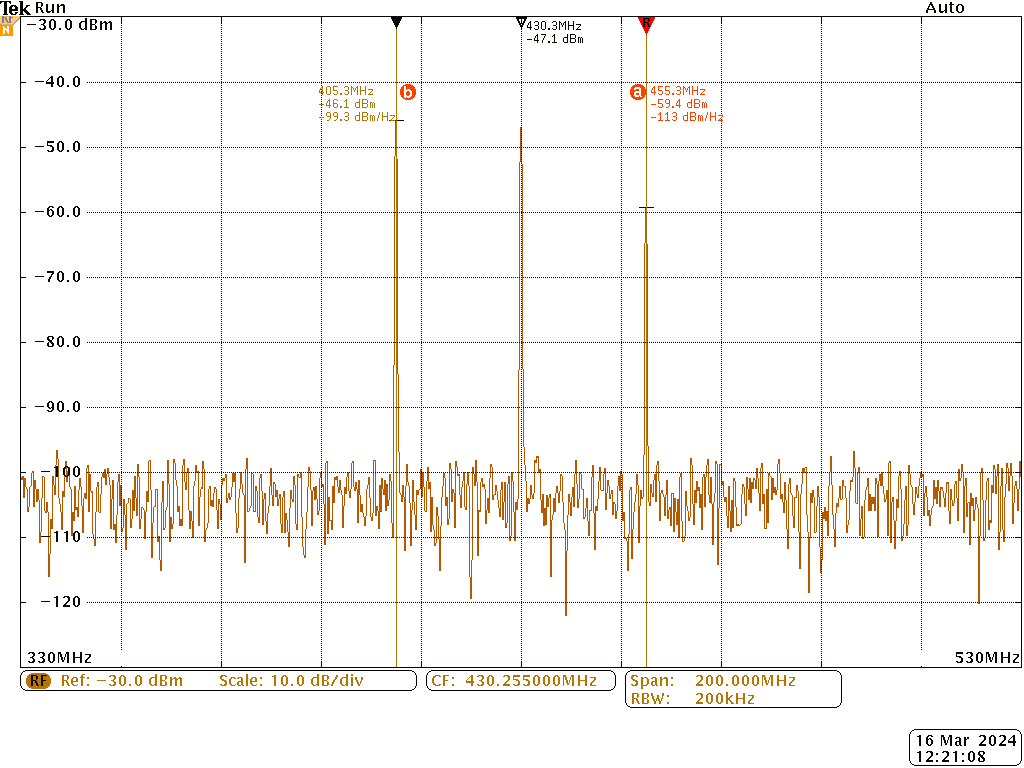
Tests/Mar16th/tek00018.png
