rhit-gardneml/Macrophthalmus/Tests/Mar16th/tek00019.png

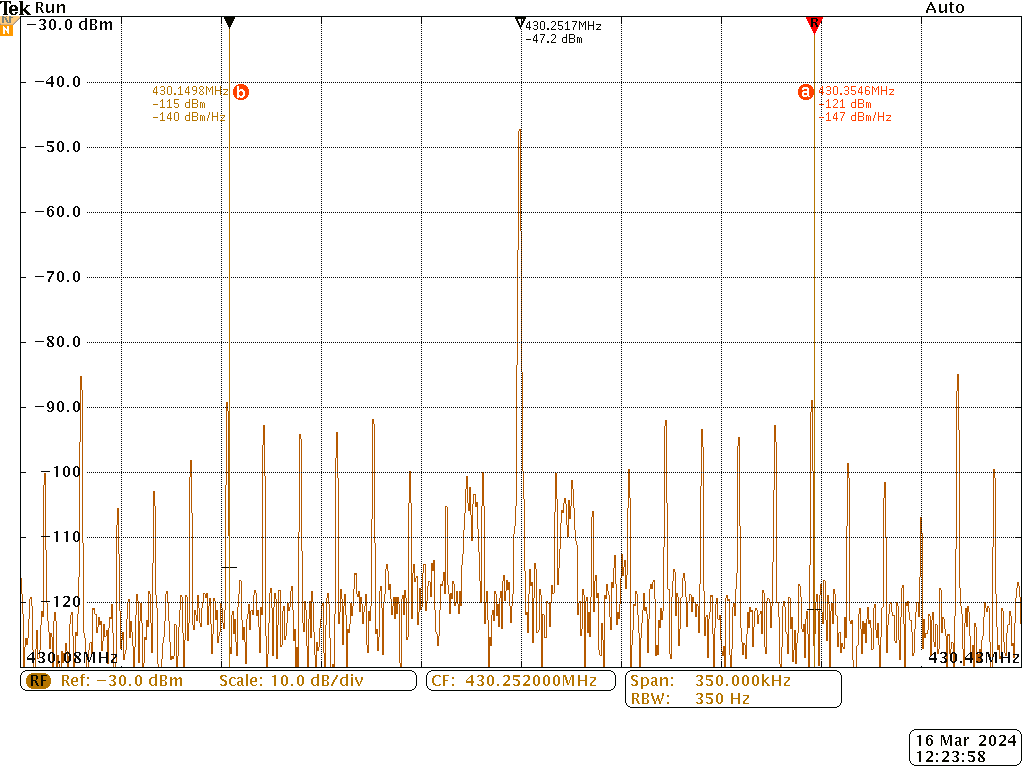
Tests/Mar16th/tek00019.png
