rhit-gardneml/Macrophthalmus/Tests/Mar16th/tek00020.png

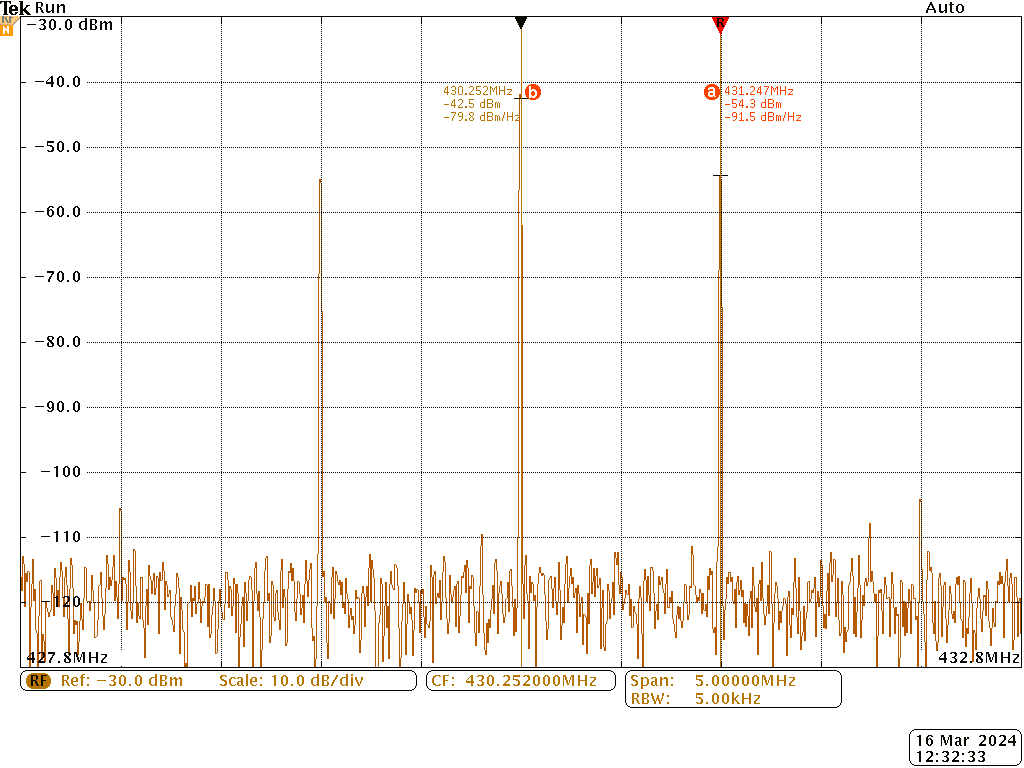
Tests/Mar16th/tek00020.png
