rhit-gardneml/Macrophthalmus/Tests/Mar16th/tek00021.png

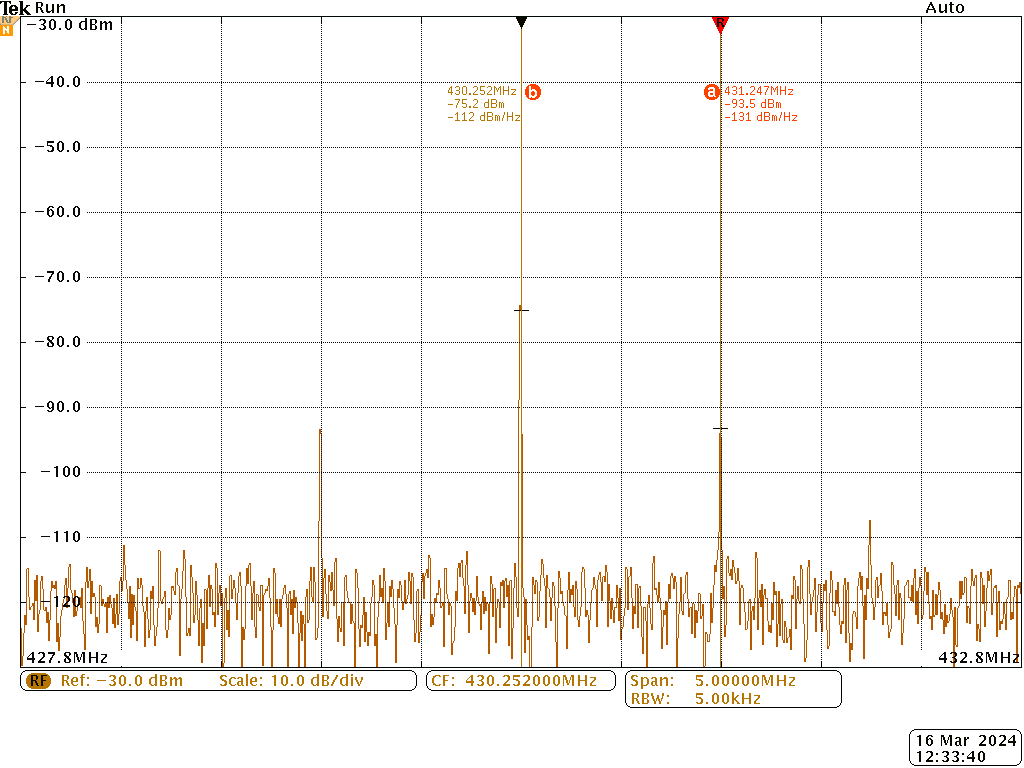
Tests/Mar16th/tek00021.png
