rhit-gardneml/Macrophthalmus/Tests/Mar16th/tek00022.png

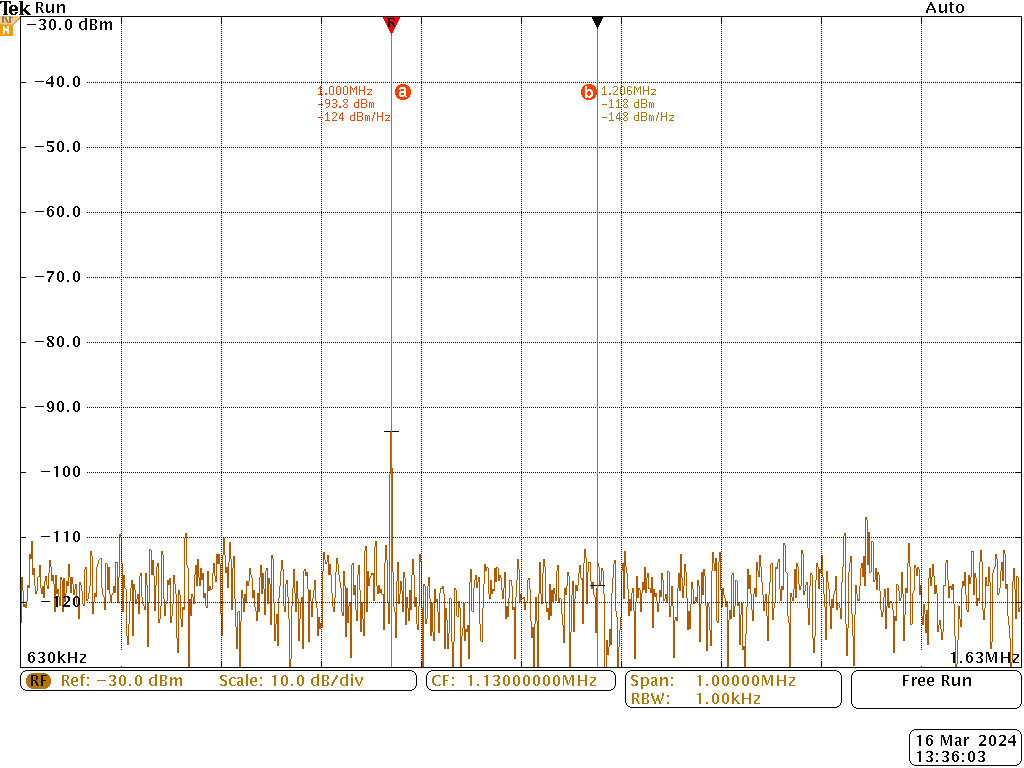
Tests/Mar16th/tek00022.png
