rhit-gardneml/Macrophthalmus/Tests/Mar16th/tek00023.png

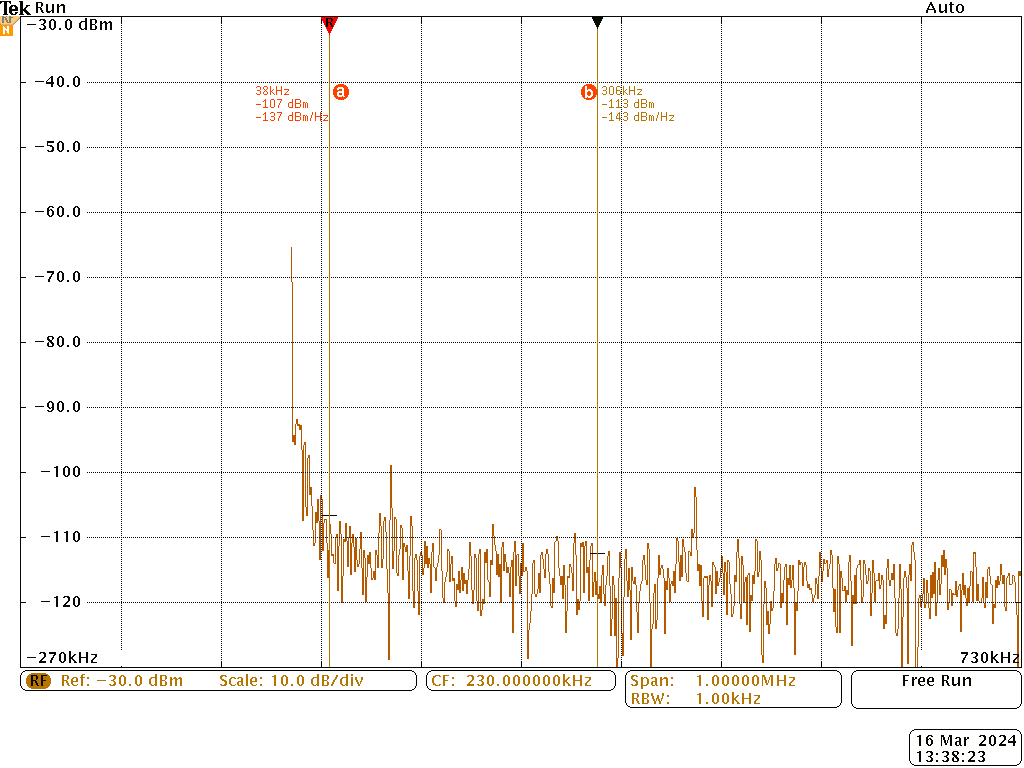
Tests/Mar16th/tek00023.png
