rhit-gardneml/Macrophthalmus/Tests/Mar17/tek00024.png

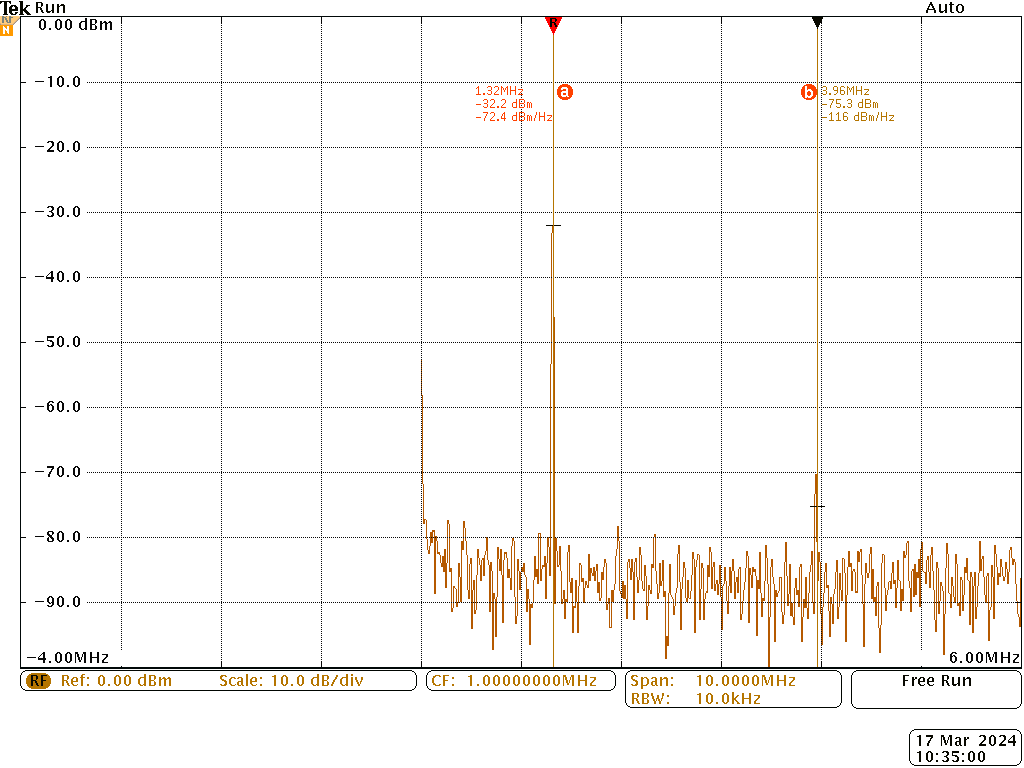
Tests/Mar17/tek00024.png
