rhit-gardneml/Macrophthalmus/Tests/Mar17/tek00025.png

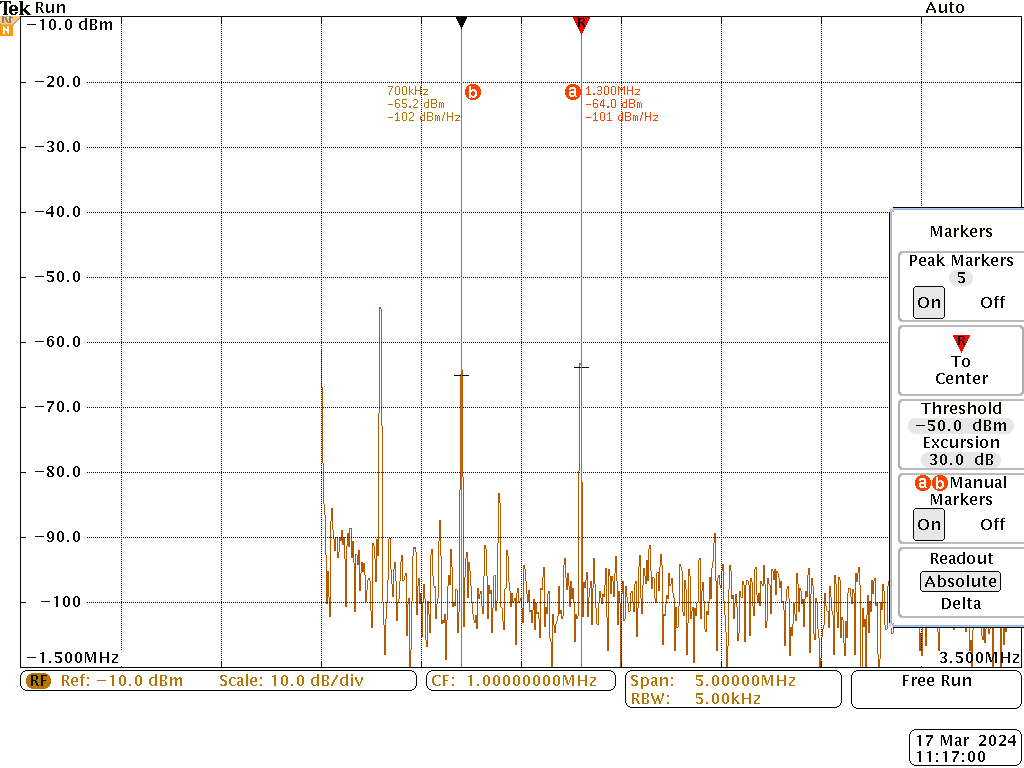
Tests/Mar17/tek00025.png
