rhit-gardneml/Macrophthalmus/Tests/Mar17/tek00026.png

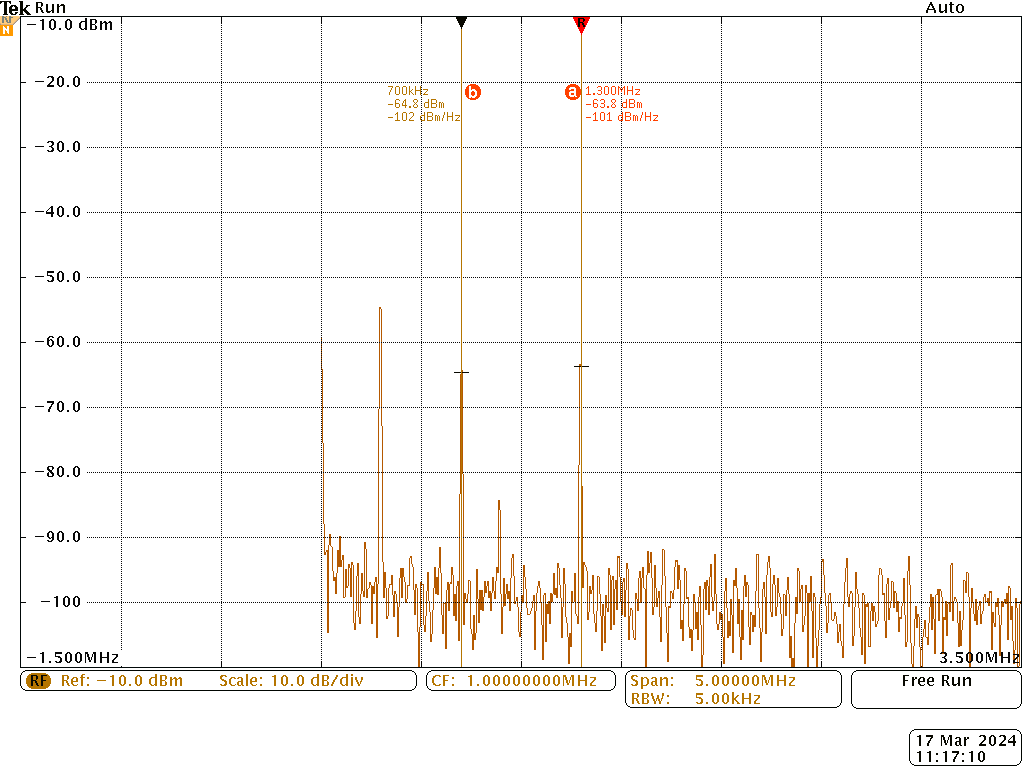
Tests/Mar17/tek00026.png
