rhit-gardneml/Macrophthalmus/Tests/Mar17/tek00029.png

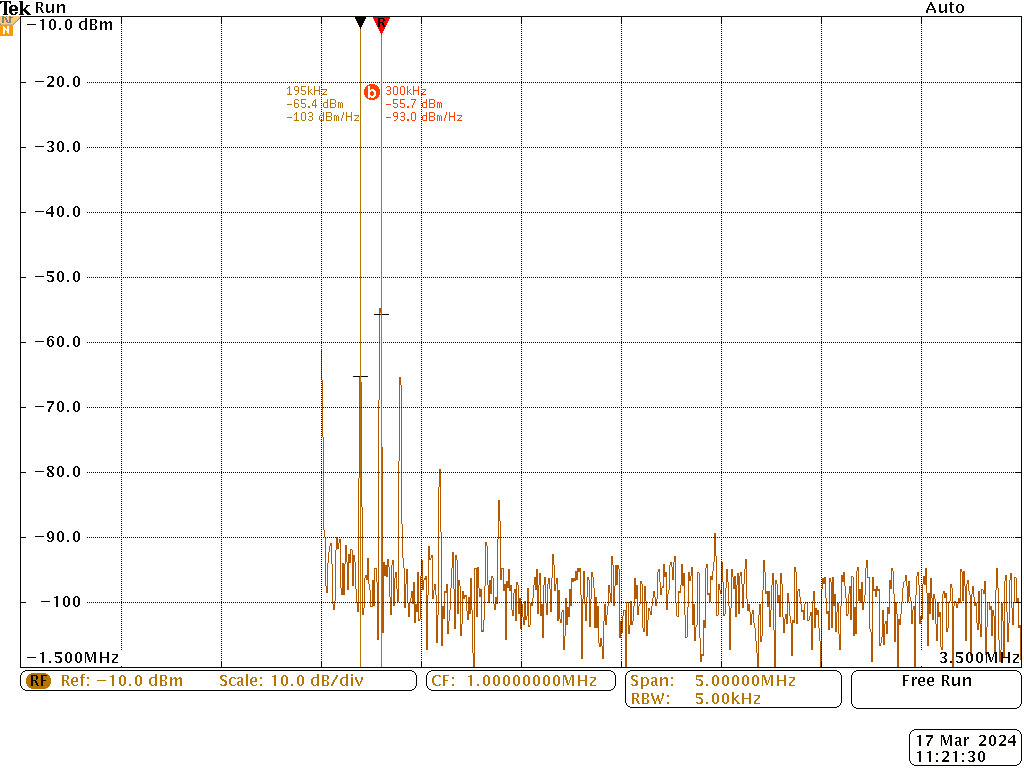
Tests/Mar17/tek00029.png
