rhit-gardneml/Macrophthalmus/Tests/Mixer/Downsample/2_MHz.png

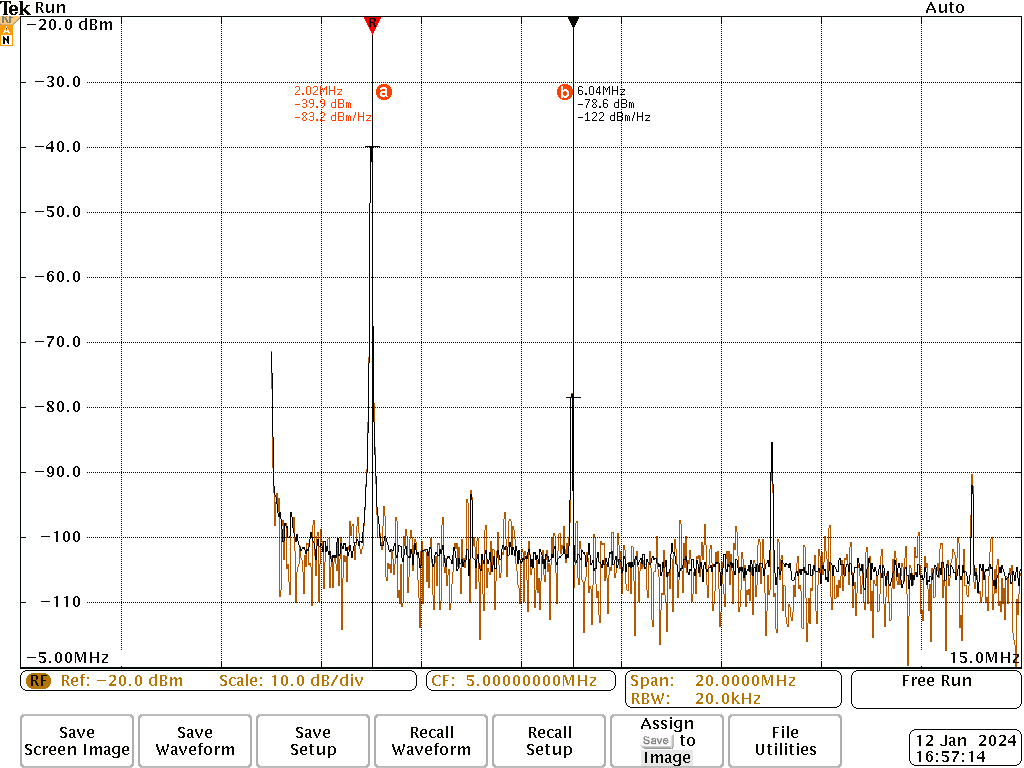
Tests/Mixer/Downsample/2_MHz.png
