rhit-gardneml/Macrophthalmus/Tests/Mixer/Downsample/2MHz_wide.png

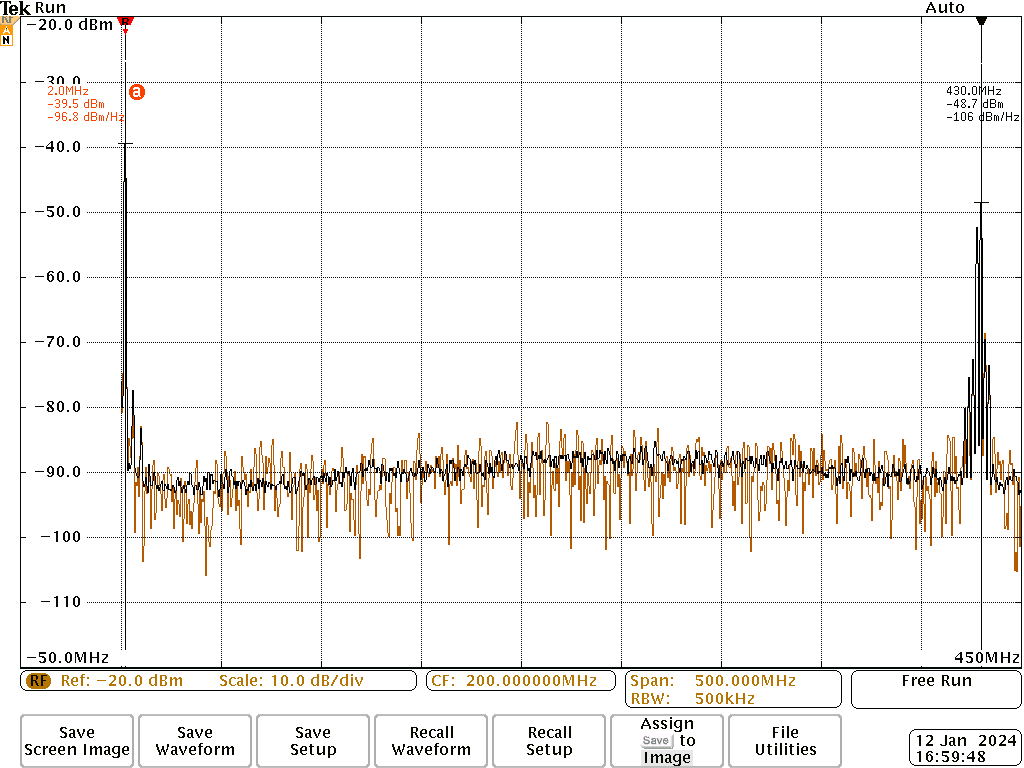
Tests/Mixer/Downsample/2MHz_wide.png
