rhit-gardneml/Macrophthalmus/Tests/Mixer/Downsample/DownSample.png

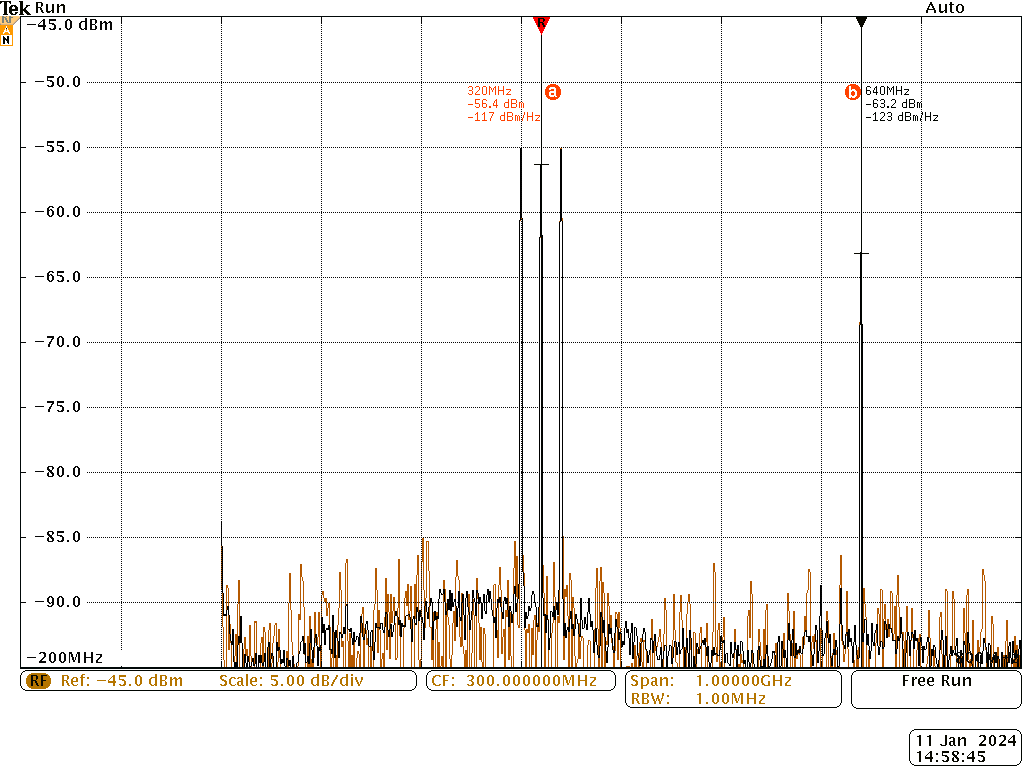
Tests/Mixer/Downsample/DownSample.png
