rhit-gardneml/Macrophthalmus/Tests/Mixer/Downsample/Downsample_W_LNA.png

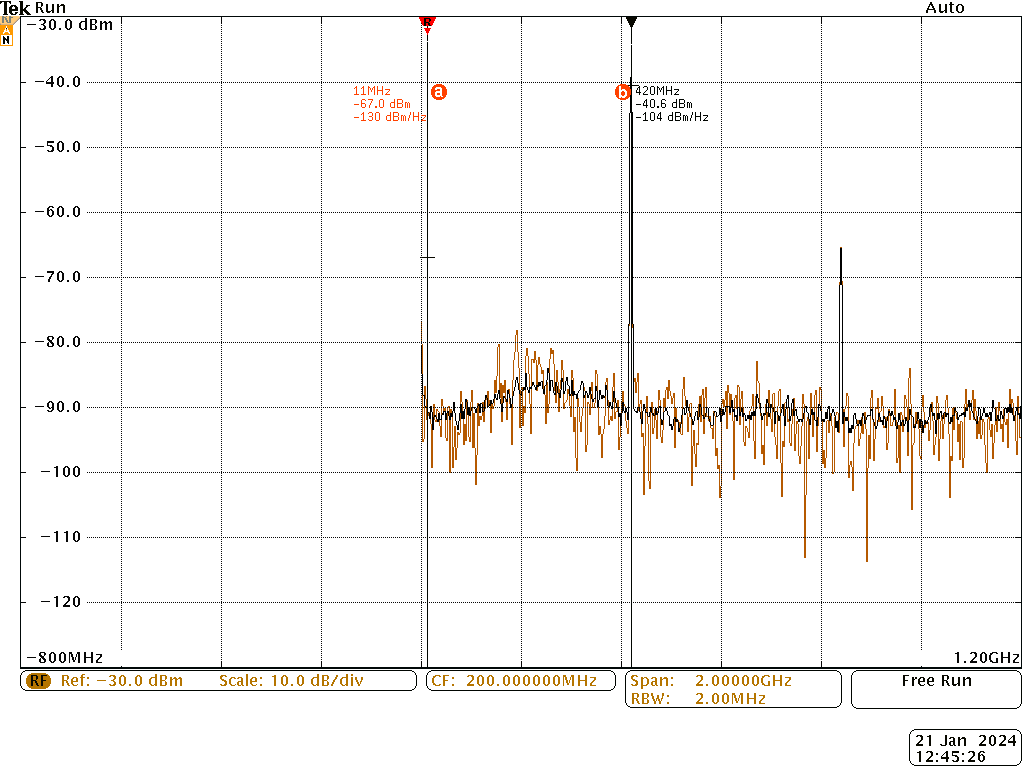
Tests/Mixer/Downsample/Downsample_W_LNA.png
