rhit-gardneml/Macrophthalmus/Tests/Mixer/Upsample/Upsample_10_420_W_Harmonics.png

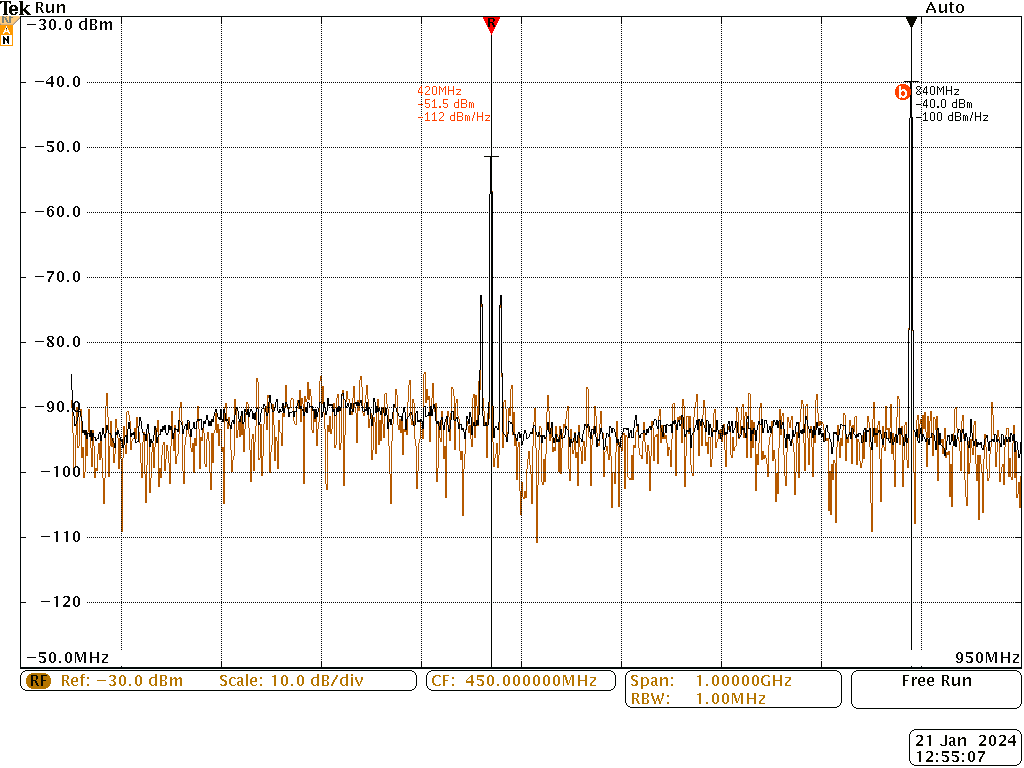
Tests/Mixer/Upsample/Upsample_10_420_W_Harmonics.png
