rhit-gardneml/Macrophthalmus/Tests/Mixer/Upsample/Upsample_10MHz_420MHz.png

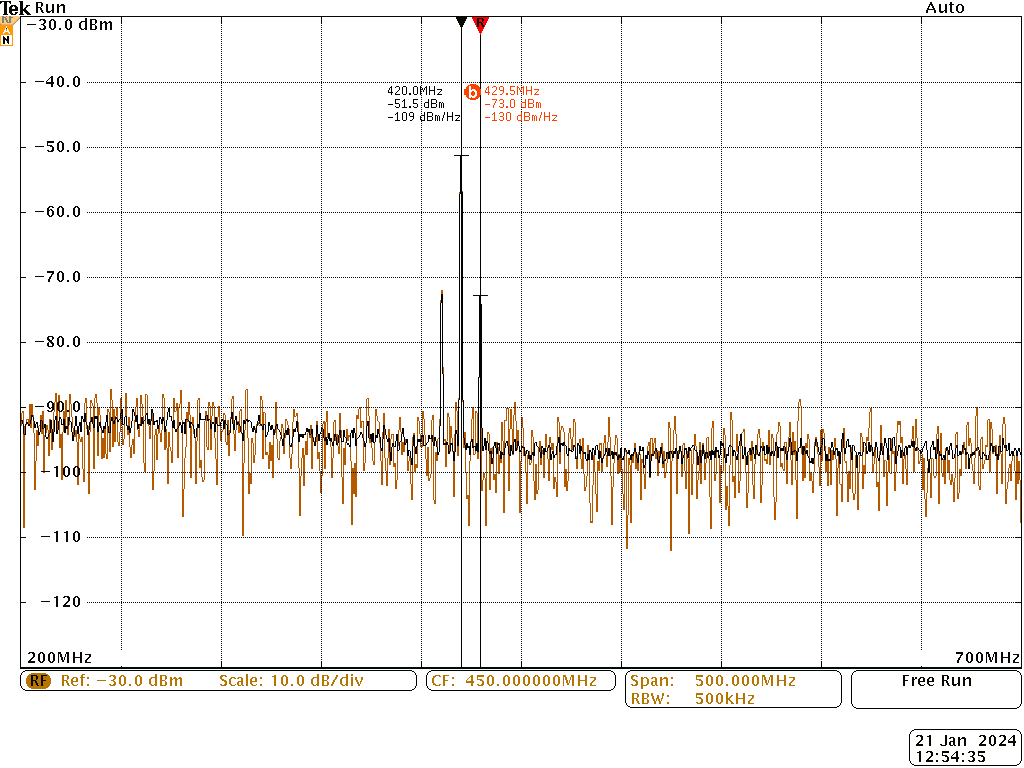
Tests/Mixer/Upsample/Upsample_10MHz_420MHz.png
