rhit-gardneml/Macrophthalmus/Tests/NewMixer/BASE.png

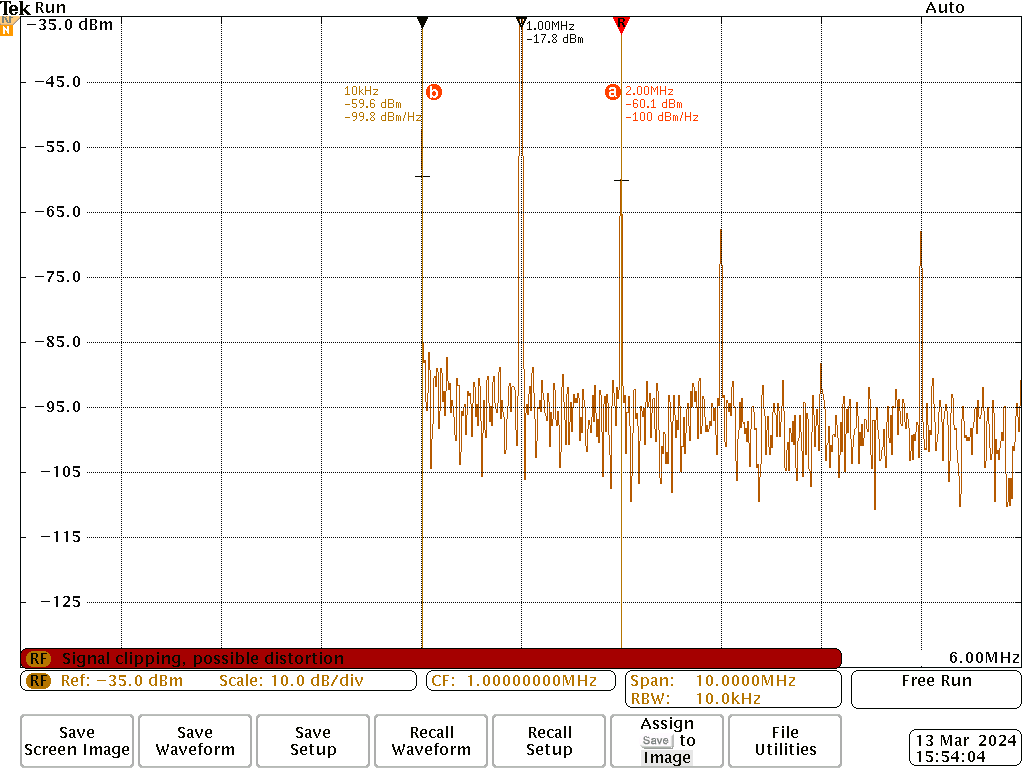
Tests/NewMixer/BASE.png
