rhit-gardneml/Macrophthalmus/Tests/NewMixer/FC.png

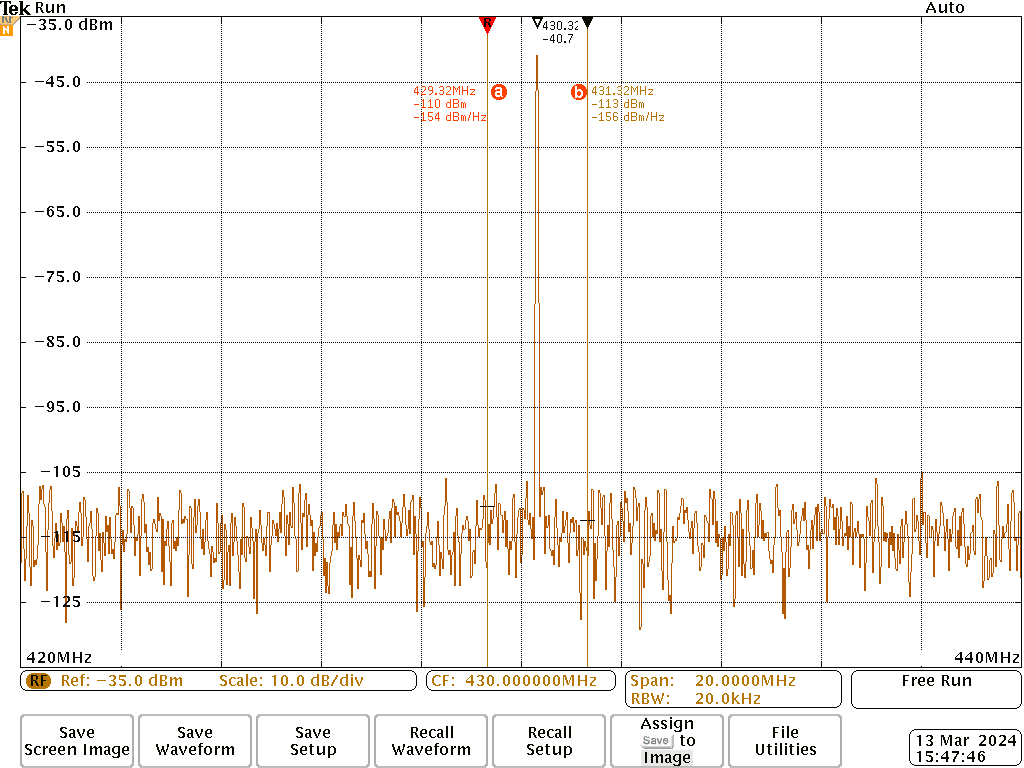
Tests/NewMixer/FC.png
