rhit-gardneml/Macrophthalmus/Tests/NewMixer/MOD.png

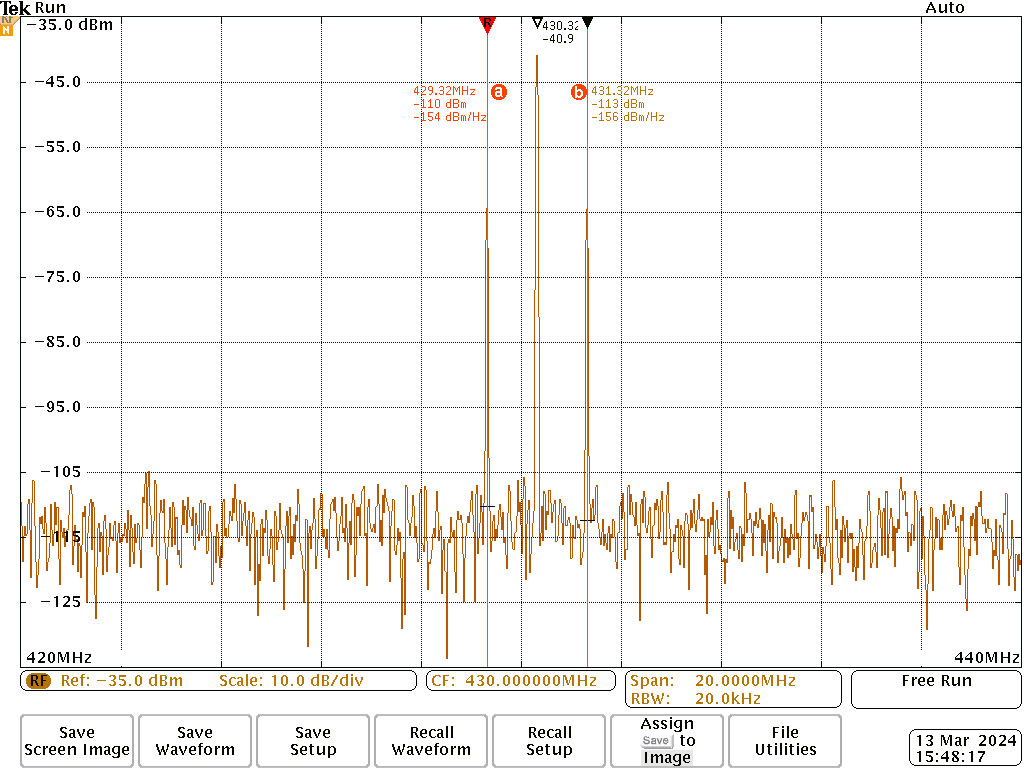
Tests/NewMixer/MOD.png
