rhit-gardneml/Macrophthalmus/Tests/VoltageCONTROLLEDOscilator/VCO.Png

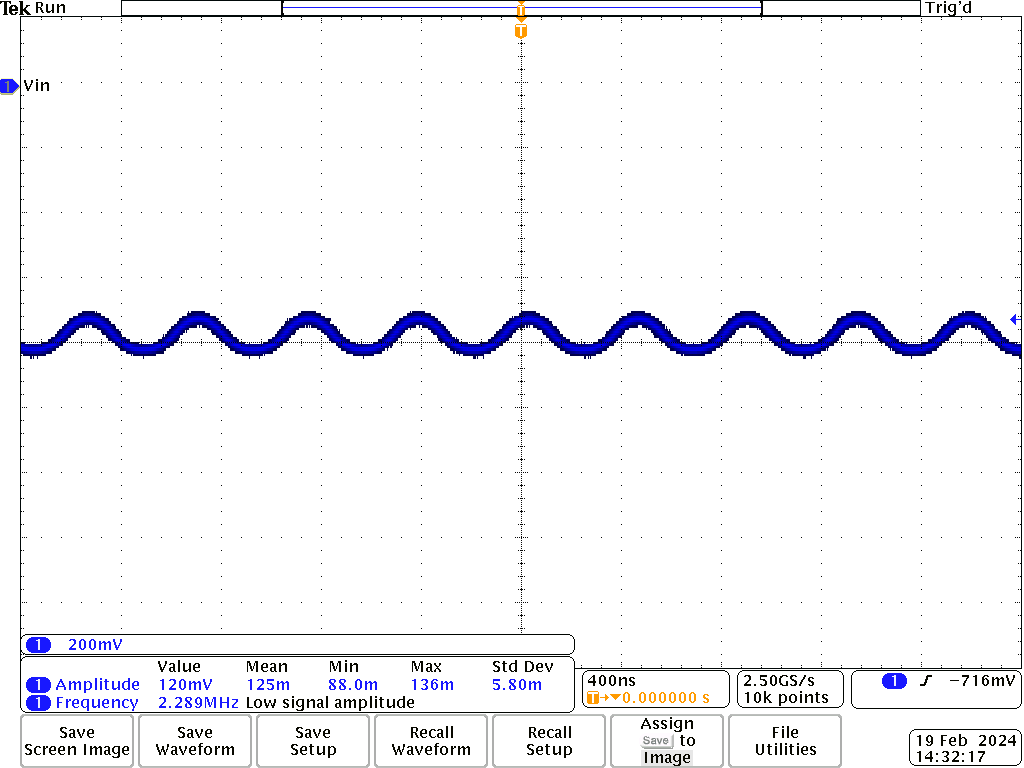
Tests/VoltageCONTROLLEDOscilator/VCO.Png
