rhit-gardneml/Macrophthalmus/Eval-Boards/DC-Offset-Amp/DC-Offset-Amp/DC-Offset-Amp.kicad_pcb

## KiCad design Eval-Boards/DC-Offset-Amp/DC-Offset-Amp/DC-Offset-Amp.kicad_pcb (2024-03-20)

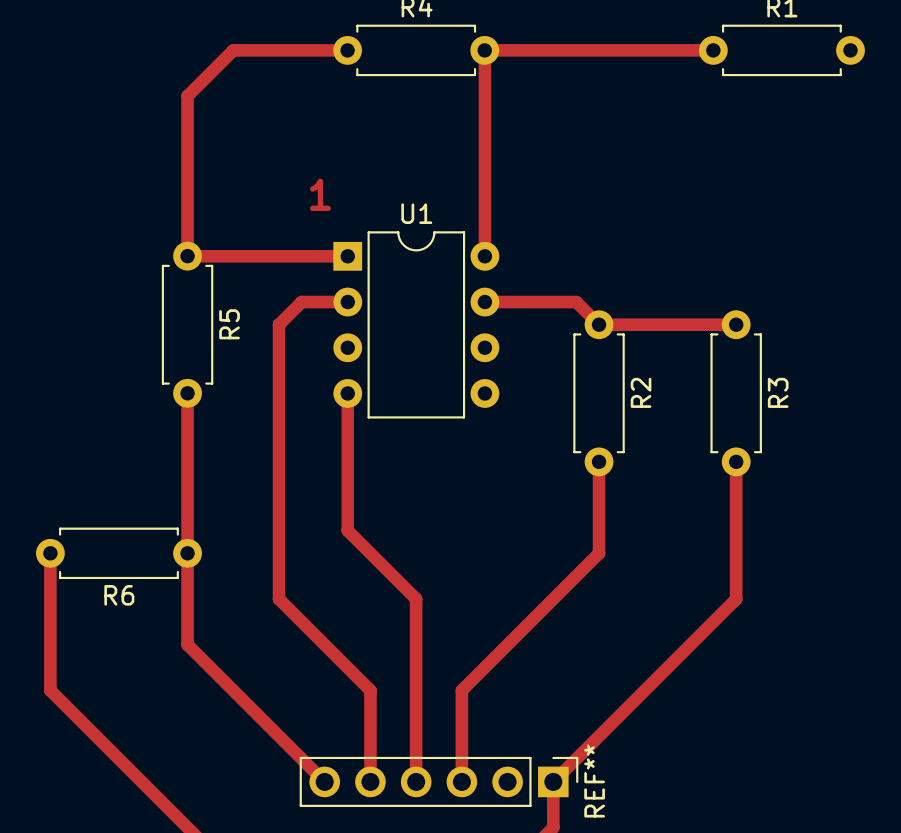
[picture p51: board DC-Offset-Amp.kicad_pcb from above]

Board: 2 copper layers, 7 parts (0 on the bottom side), 2 nets.

Parts:
R1, R2, R3, R4, R5, R6: R; R_Axial_DIN0207_L6.3mm_D2.5mm_P7.62mm_Horizontal
U1: LM380N-8; DIP-8_W7.62mm

Connections:
unnamed: R1.1, R4.2, U1.8 (BYPASS)
unnamed: R2.1, R3.1, U1.7 (VS)
