rhit-gardneml/Macrophthalmus/UHF-PCB-6layer/UHF-PCB-6layer.kicad_pcb

## KiCad design UHF-PCB-6layer/UHF-PCB-6layer.kicad_pcb (2024-01-18)

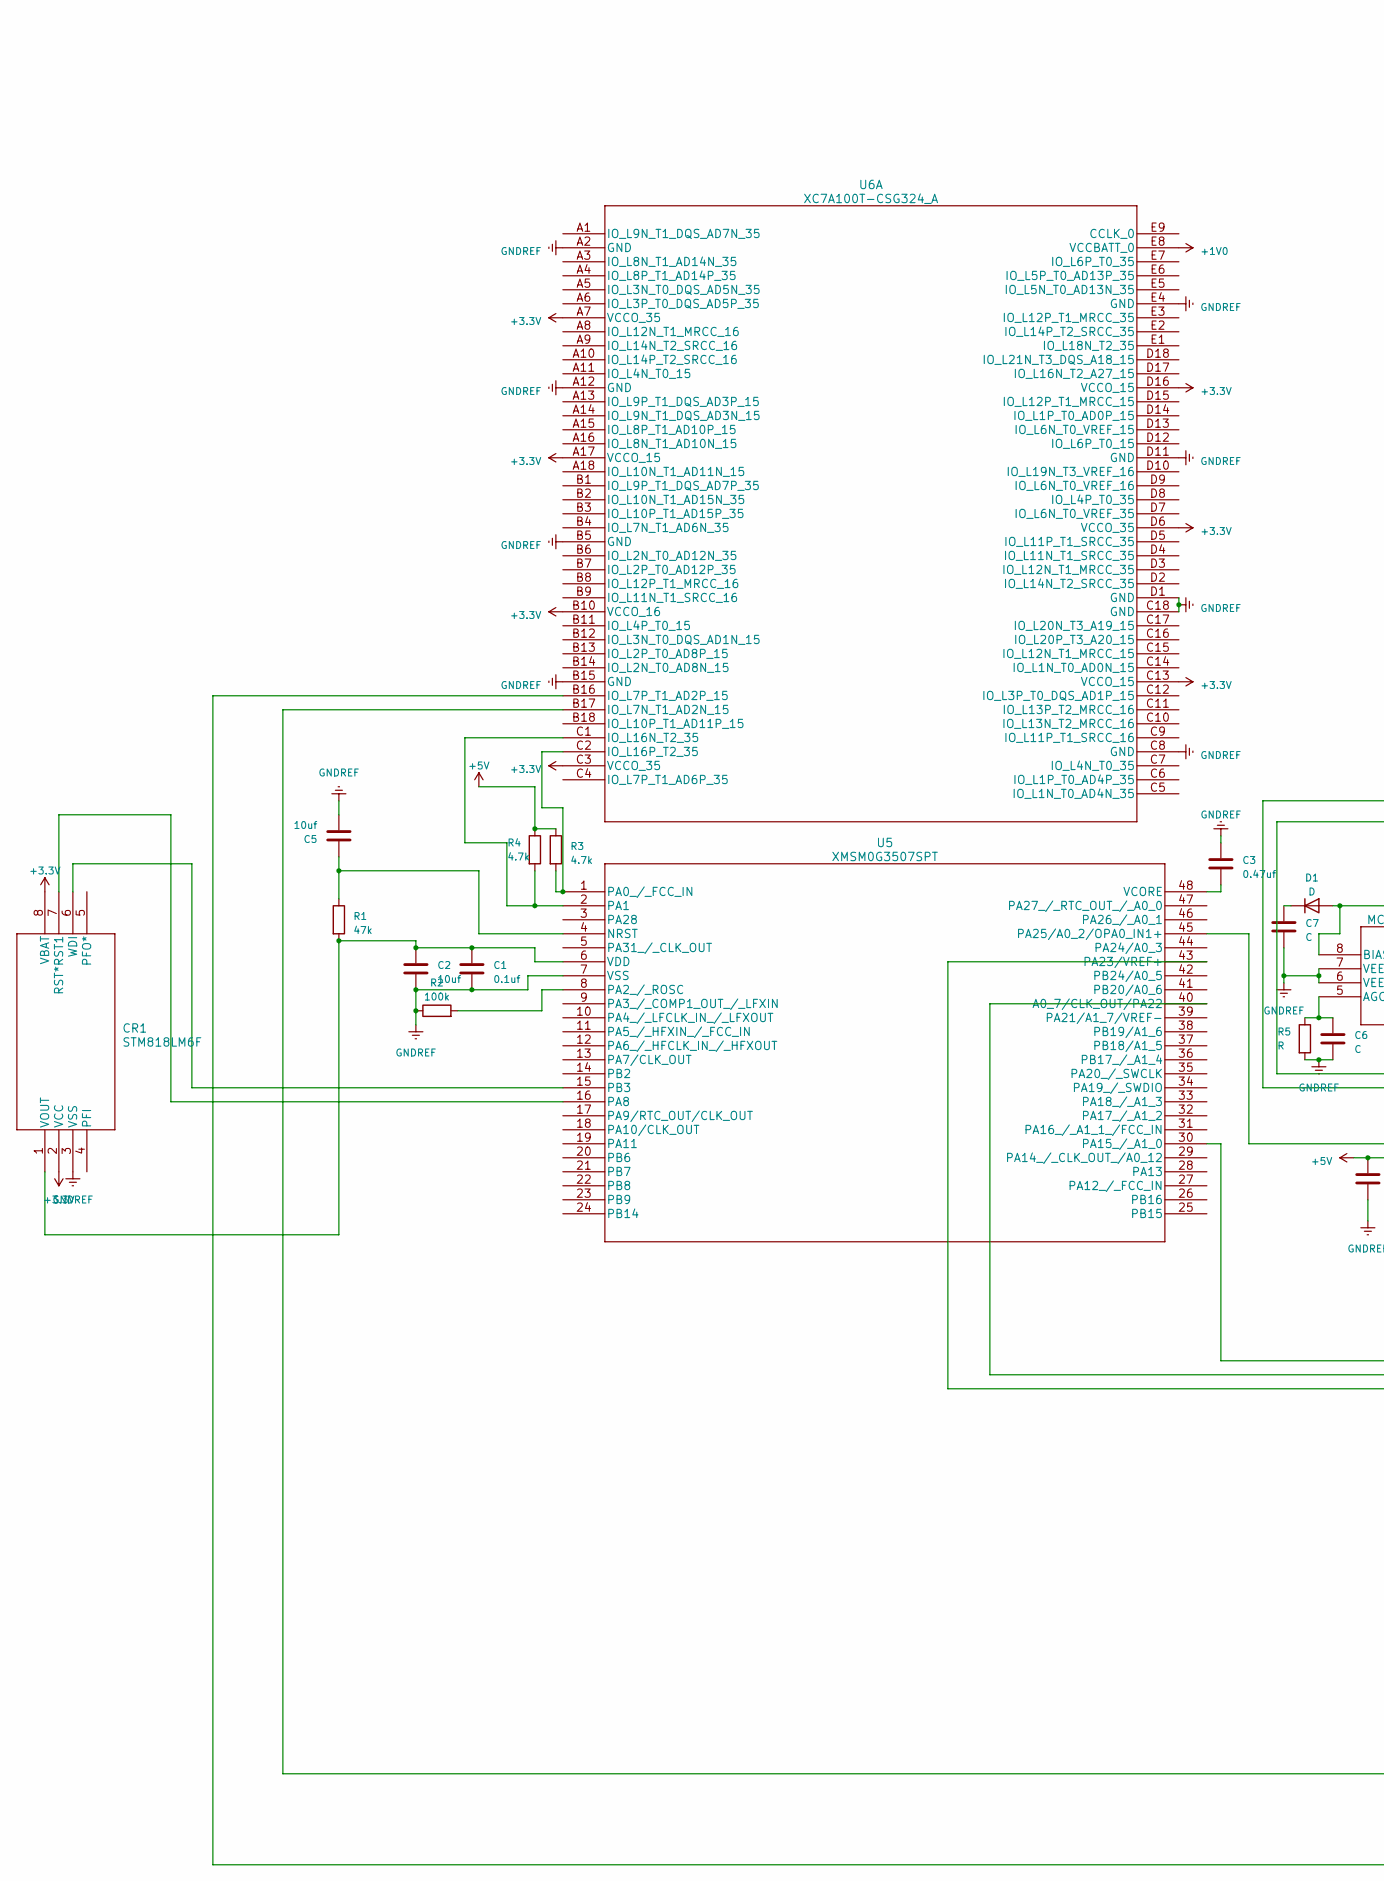
[picture p52: schematic UHF-PCB-6layer.kicad_sch, UHF PCB with Dual Microcontroller and FGPA, part in row 1, column 1]

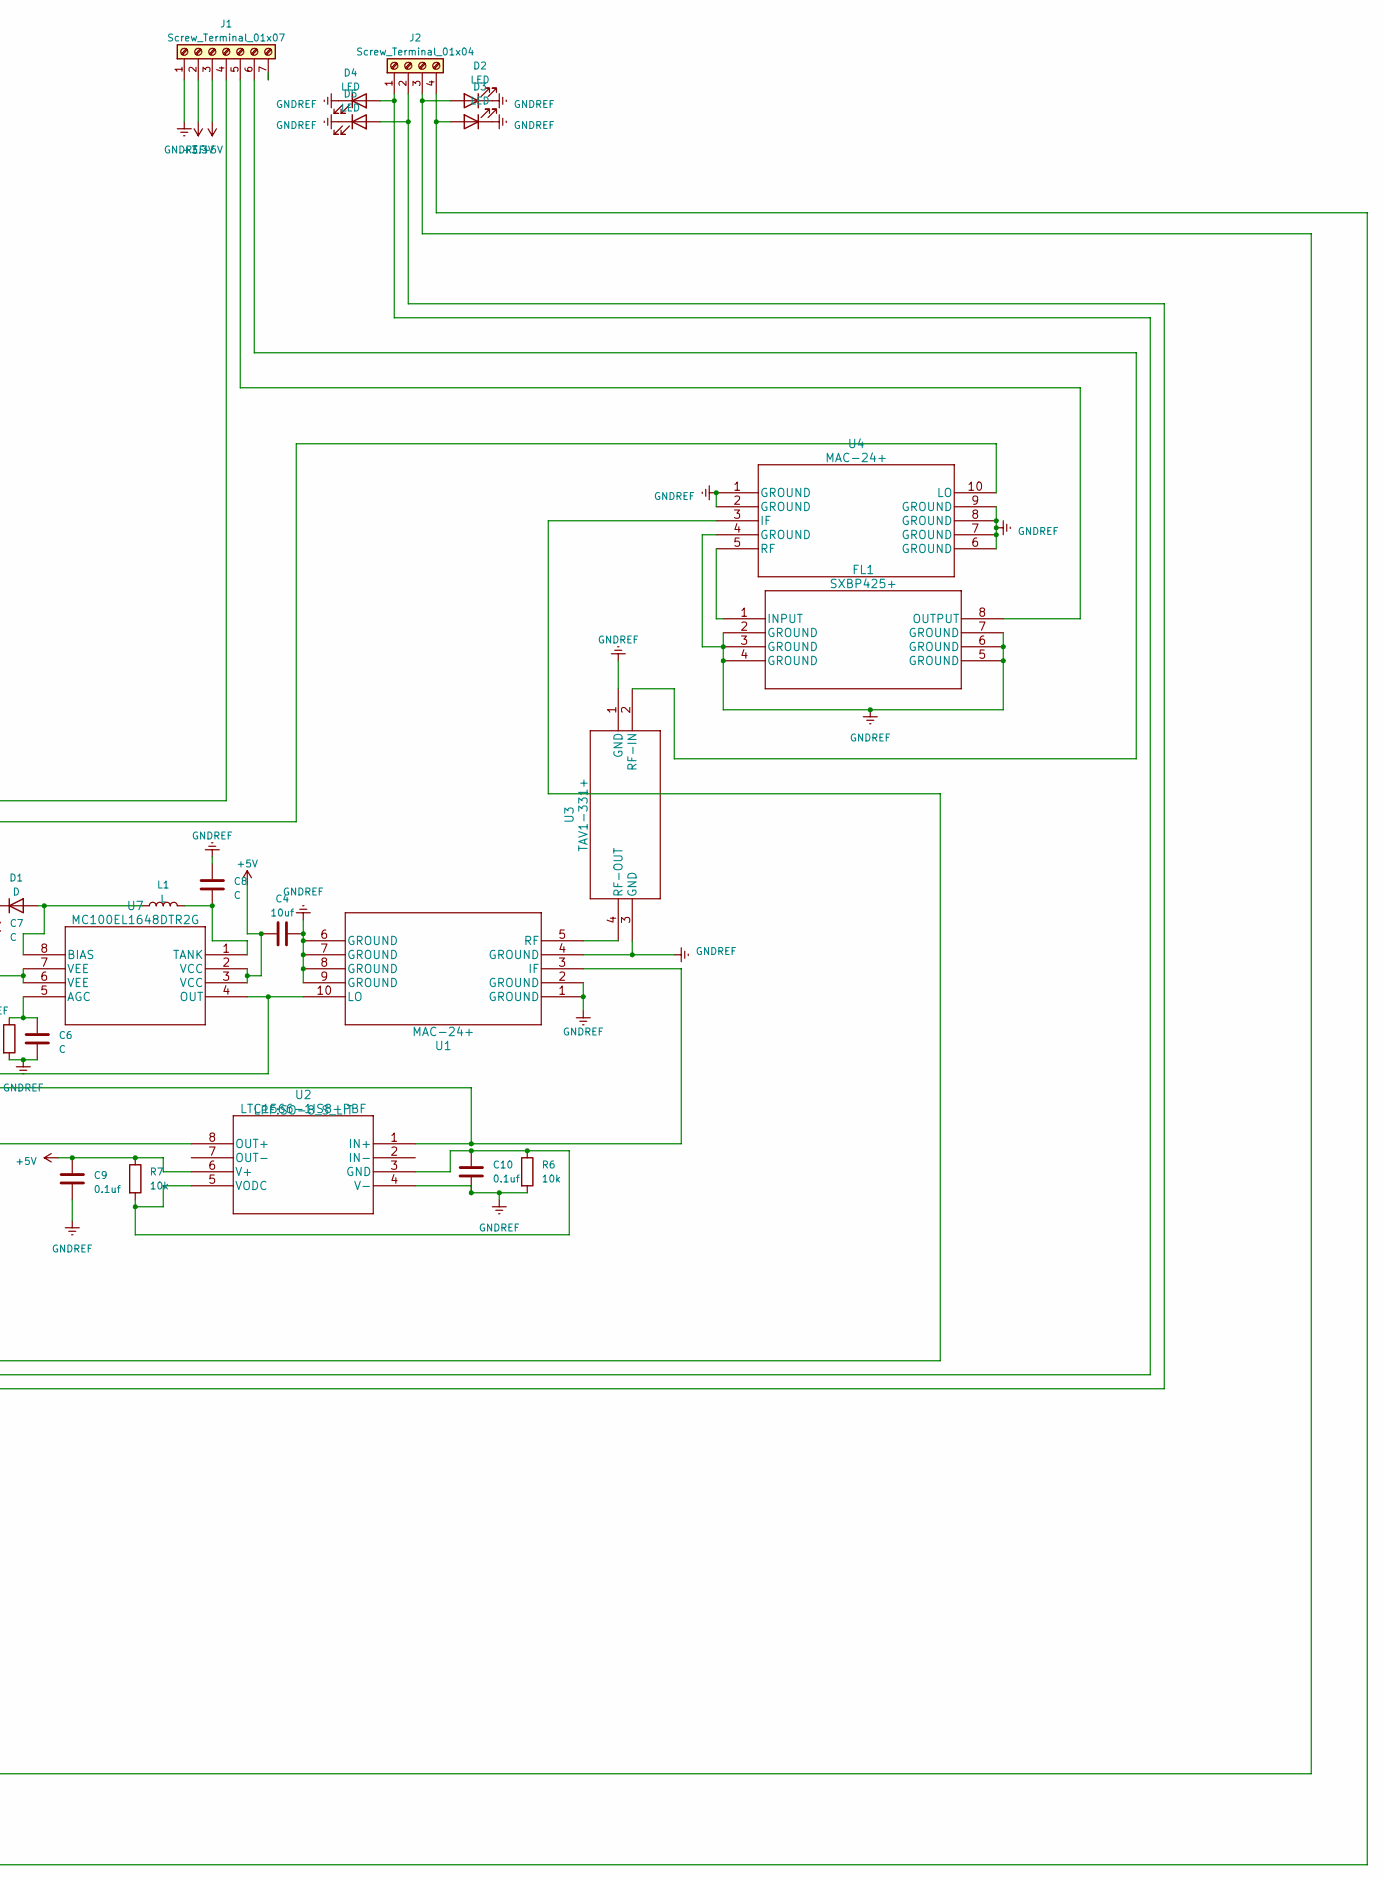
[picture p53: schematic UHF-PCB-6layer.kicad_sch, UHF PCB with Dual Microcontroller and FGPA, part in row 1, column 2]

Parts:
C1, C9, C10: 0.1uf; C_0603_1608Metric
C2, C4, C5: 10uf; C_0603_1608Metric
C3: 0.47uf; C_0603_1608Metric
C6, C7, C8: C; C_0603_1608Metric
CR1: STM818LM6F; SO-8_STM
D1: D; D_0603_1608Metric
D2, D3, D4, D5: LED; LED_2010_5025Metric_Pad1.52x2.65mm_HandSolder
FL1: SXBP425+; HF1139_MNC
J1: Screw_Terminal_01x07; Altech_AK300_1x07_P5.00mm_45-Degree
J2: Screw_Terminal_01x04; Altech_AK300_1x07_P5.00mm_45-Degree
L1: L; L_0603_1608Metric
R1: 47k; R_0603_1608Metric
R2: 100k; R_0603_1608Metric
R3, R4: 4.7k; R_0603_1608Metric
R5: R; R_0603_1608Metric
R6, R7: 10k; R_0603_1608Metric
U1, U4: MAC-24+; DZ1650_MNC
U2: LTC1566-1IS8-PBF; SO-8_S_LIT
U3: TAV1-331+; TE2769_MNC
U5: XMSM0G3507SPT; LQFP48_PT_TEX
U6: XC7A100T-CSG324_A; CS&slash_CSG324_XIL
U7: MC100EL1648DTR2G; TSSOP8_3P10X3P10_ONS

Connections:
+1V0: U6.E8 (VCCBATT_0)
+3.3V: CR1.2 (VCC), CR1.8 (VBAT), J1.2, U6.A7 (VCCO_35), U6.A17 (VCCO_15), U6.B10 (VCCO_16), U6.C3 (VCCO_35), U6.C13 (VCCO_15), U6.D6 (VCCO_35), U6.D16 (VCCO_15)
+5V: C4.2, C9.1, J1.3, R3.1, R4.1, R7.1, U2.6 (V+), U7.2 (VCC), U7.3 (VCC)
GNDREF: C1.1, C2.1, C3.2, C4.1, C5.1, C6.1, C7.2, C8.2, C9.2, C10.2, CR1.3 (VSS), D2.1 (K), D3.1 (K), D4.1 (K), D5.1 (K), FL1.2 (GROUND), FL1.3 (GROUND), FL1.4 (GROUND), FL1.5 (GROUND), FL1.6 (GROUND), FL1.7 (GROUND), J1.1, R2.1, R5.2, R6.2, U1.1 (GROUND), U1.2 (GROUND), U1.4 (GROUND), U1.6 (GROUND), U1.7 (GROUND), U1.8 (GROUND), U1.9 (GROUND), U2.4 (V-), U3.1 (GND), U3.3 (GND), U4.1 (GROUND), U4.2 (GROUND), U4.4 (GROUND), U4.6 (GROUND), U4.7 (GROUND), U4.8 (GROUND), U4.9 (GROUND), U5.7 (VSS), U6.A2 (GND), U6.A12 (GND), U6.B5 (GND), U6.B15 (GND), U6.C8 (GND), U6.C18 (GND), U6.D1 (GND), U6.D11 (GND), U6.E4 (GND), U7.6 (VEE), U7.7 (VEE)
unnamed: CR1.7 (RST*RST1), U5.16 (PA8)
unnamed: C1.2, C2.2, CR1.1 (VOUT), R1.2, U5.6 (VDD)
unnamed: CR1.6 (WDI), U5.15 (PB3)
unnamed: D1.2 (A), L1.1, U7.8 (BIAS)
unnamed: C7.1, D1.1 (K)
unnamed: D2.2 (A), J2.3, U6.B17 (IO_L7N_T1_AD2N_15)
unnamed: D3.2 (A), J2.4, U6.B16 (IO_L7P_T1_AD2P_15)
unnamed: D4.2 (A), J2.1, U5.40 (A0_7/CLK_OUT/PA22)
unnamed: D5.2 (A), J2.2, U5.43 (PA23/VREF+)
unnamed: FL1.1 (INPUT), U4.5 (RF)
unnamed: FL1.8 (OUTPUT), J1.5
unnamed: J1.4, U1.3 (IF), U2.1 (IN+)
unnamed: J1.6, U3.2 (RF-IN)
unnamed: U1.10 (LO), U4.10 (LO), U7.4 (OUT)
unnamed: U1.5 (RF), U3.4 (RF-OUT)
unnamed: C10.1, R6.1, R7.2, U2.3 (GND), U2.5 (VODC)
unnamed: U2.8 (OUT+), U5.45 (PA25/A0_2/OPA0_IN1+)
unnamed: U4.3 (IF), U5.30 (PA15_/_A1_0)
unnamed: C5.2, R1.1, U5.4 (NRST)
unnamed: R3.2, U5.1 (PA0_/_FCC_IN), U6.C2 (IO_L16P_T2_35)
unnamed: R4.2, U5.2 (PA1), U6.C1 (IO_L16N_T2_35)
unnamed: R2.2, U5.8 (PA2_/_ROSC)
unnamed: C3.1, U5.48 (VCORE)
unnamed: C6.2, R5.1, U7.5 (AGC)
unnamed: C8.1, L1.2, U7.1 (TANK)

Board: 2 copper layers, 34 parts (0 on the bottom side), 28 nets, no tracks yet.
