rhit-gardneml/Macrophthalmus/FPGA-Code/UART_FPGA/UARTTypewriter/UartTyperwriter2023fall.runs/synth_1/.Xil/UartTyperwriter2023fall_propImpl.xdc

set_property SRC_FILE_INFO {cfile:C:/Users/hoatsosa/Xilinx/ECE433/UARTTypewriter/UartTyperwriter2023fall.srcs/constrs_1/imports/Sources_UartTyperwriter2023fall/UartTyperwriter2023fall.xdc rfile:../../../UartTyperwriter2023fall.srcs/constrs_1/imports/Sources_UartTyperwriter2023fall/UartTyperwriter2023fall.xdc id:1} [current_design]
set_property src_info {type:XDC file:1 line:4 export:INPUT save:INPUT read:READ} [current_design]
set_property PACKAGE_PIN E3 [get_ports clock]
set_property src_info {type:XDC file:1 line:6 export:INPUT save:INPUT read:READ} [current_design]
set_property PACKAGE_PIN D9 [get_ports reset]
set_property src_info {type:XDC file:1 line:10 export:INPUT save:INPUT read:READ} [current_design]
set_property PACKAGE_PIN F3 [get_ports rx]
set_property src_info {type:XDC file:1 line:11 export:INPUT save:INPUT read:READ} [current_design]
set_property PACKAGE_PIN F4 [get_ports tx]
set_property src_info {type:XDC file:1 line:13 export:INPUT save:INPUT read:READ} [current_design]
set_property PACKAGE_PIN H5 [get_ports {transmitted_bits[7]}]
set_property src_info {type:XDC file:1 line:14 export:INPUT save:INPUT read:READ} [current_design]
set_property PACKAGE_PIN J5 [get_ports {transmitted_bits[6]}]
set_property src_info {type:XDC file:1 line:15 export:INPUT save:INPUT read:READ} [current_design]
set_property PACKAGE_PIN T9 [get_ports {transmitted_bits[5]}]
set_property src_info {type:XDC file:1 line:16 export:INPUT save:INPUT read:READ} [current_design]
set_property PACKAGE_PIN T10 [get_ports {transmitted_bits[4]}]
set_property src_info {type:XDC file:1 line:17 export:INPUT save:INPUT read:READ} [current_design]
set_property PACKAGE_PIN F6 [get_ports {transmitted_bits[3]}]
set_property src_info {type:XDC file:1 line:18 export:INPUT save:INPUT read:READ} [current_design]
set_property PACKAGE_PIN J4 [get_ports {transmitted_bits[2]}]
set_property src_info {type:XDC file:1 line:19 export:INPUT save:INPUT read:READ} [current_design]
set_property PACKAGE_PIN J2 [get_ports {transmitted_bits[1]}]
set_property src_info {type:XDC file:1 line:20 export:INPUT save:INPUT read:READ} [current_design]
set_property PACKAGE_PIN H6 [get_ports {transmitted_bits[0]}]
