rhit-gardneml/Macrophthalmus/FPGA-Code/BPSK_modulation/BPSK_modulation/BPSK_modulation.srcs/sources_1/imports/sine_testbench/sine_package.vhd

library ieee;
use ieee.std_logic_1164.all;

package sine_package is

  constant max_table_value: integer := 127;
  subtype table_value_type is integer range 0 to max_table_value;

  constant max_table_index: integer := 127;
  subtype table_index_type is integer range 0 to max_table_index;

  subtype sine_vector_type is std_logic_vector( 7 downto 0 );

  function get_table_value (table_index: table_index_type) return table_value_type;

end;

package body sine_package is

  function get_table_value (table_index: table_index_type) return table_value_type is
    variable table_value: table_value_type;
  begin
    case table_index is
      when 0 =>
        table_value := 1;
      when 1 =>
        table_value := 2;
      when 2 =>
        table_value := 4;
      when 3 =>
        table_value := 5;
      when 4 =>
        table_value := 7;
      when 5 =>
        table_value := 9;
      when 6 =>
        table_value := 10;
      when 7 =>
        table_value := 12;
      when 8 =>
        table_value := 13;
      when 9 =>
        table_value := 15;
      when 10 =>
        table_value := 16;
      when 11 =>
        table_value := 18;
      when 12 =>
        table_value := 19;
      when 13 =>
        table_value := 21;
      when 14 =>
        table_value := 22;
      when 15 =>
        table_value := 24;
      when 16 =>
        table_value := 26;
      when 17 =>
        table_value := 27;
      when 18 =>
        table_value := 29;
      when 19 =>
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
      when 114 =>
        table_value := 125;
      when 115 =>
        table_value := 126;
      when 116 =>
        table_value := 126;
      when 117 =>
        table_value := 126;
      when 118 =>
        table_value := 126;
      when 119 =>
        table_value := 126;
      when 120 =>
        table_value := 126;
      when 121 =>
        table_value := 127;
      when 122 =>
        table_value := 127;
      when 123 =>
        table_value := 127;
      when 124 =>
        table_value := 127;
      when 125 =>
        table_value := 127;
      when 126 =>
        table_value := 127;
      when 127 =>
        table_value := 127;
    end case;
    return table_value;
  end;

end;
