rhit-gardneml/Macrophthalmus/FPGA-Code/UART_FPGA/UARTTypewriter/Sources_UartTyperwriter2023fall/uart_tx.v

//
//////////////////////////////////////////////////////////////////////////////////
// Copyright © 2010, Xilinx, Inc.
// This file contains confidential and proprietary information of Xilinx, Inc. and is
// protected under U.S. and international copyright and other intellectual property laws.
//////////////////////////////////////////////////////////////////////////////////
//
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
// CRITICAL APPLICATIONS
// Xilinx products are not designed or intended to be fail-safe, or for use in any
// application requiring fail-safe performance, such as life-support or safety
// devices or systems, Class III medical devices, nuclear facilities, applications
// related to the deployment of airbags, or any other applications that could lead
// to death, personal injury, or severe property or environmental damage
// (individually and collectively, "Critical Applications"). Customer assumes the
// sole risk and liability of any use of Xilinx products in Critical Applications,
// subject only to applicable laws and regulations governing limitations on product
// liability.
//
// THIS COPYRIGHT NOTICE AND DISCLAIMER MUST BE RETAINED AS PART OF THIS FILE AT ALL TIMES.
//
//////////////////////////////////////////////////////////////////////////////////
//
//   ____  ____
//  /   /\/   /
// /___/  \  /    Vendor: Xilinx
// \   \   \/     Version: 2.10
//  \   \         Filename: uart_tx.v
//  /   /         Date Last Modified:  March 19 2010
// /___/   /\     Date Created: October 14 2002
// \   \  /  \
//  \___\/\___\
//
// Device: Xilinx
// Purpose: UART Transmitter with integral 16 byte FIFO buffer
//          8 bit, no parity, 1 stop bit
//
// This module was made for use with Spartan-3 Generation Devices and is also ideally 
// suited for use with Virtex-II(PRO) and Virtex-4 devices. Will also work in Virtex-5, 
// Virtex-6 and Spartan-6 devices but it is not specifically optimised for these 
// architectures.
//
//
// Contact: e-mail  picoblaze@xilinx.com
//
//
// Revision History:
//  Rev 1.00 - kc  - Start of design entry in VHDL,  October 14 2002.
//  Rev 1.01 - sus - Converted to verilog,  August 4 2004.
//  Rev 1.02 - njs - Converted to verilog 2001,  February 10 2006.
//  Rev 1.03 - kc  - Minor format changes,  January 17 2007.
//  Rev 2.10 - njs - March 19 2010.
//                   Format and text changes consistent with sub-modules.
//                   No functional changes.
//
//////////////////////////////////////////////////////////////////////////////////
//

`timescale 1 ps / 1ps

module uart_tx (
input [7:0]  data_in,
input        write_buffer,
input        reset_buffer,
input        en_16_x_baud,
output       serial_out,
output       buffer_full,
output       buffer_half_full,
input        clk);

//	 
//////////////////////////////////////////////////////////////////////////////////
//
// Signals used in UART_TX
//
//////////////////////////////////////////////////////////////////////////////////
//

wire [7:0]  fifo_data_out;
wire        fifo_data_present;
wire        fifo_read;

//
//////////////////////////////////////////////////////////////////////////////////
//
// Start of UART_TX circuit description
//
//////////////////////////////////////////////////////////////////////////////////
//	

kcuart_tx kcuart (
	.data_in	(fifo_data_out),
    	.send_character	(fifo_data_present),
    	.en_16_x_baud	(en_16_x_baud),
    	.serial_out	(serial_out),
    	.Tx_complete	(fifo_read),
    	.clk		(clk));

bbfifo_16x8 buf_0 (
	.data_in	(data_in),
    	.data_out	(fifo_data_out),
    	.reset		(reset_buffer),
    	.write		(write_buffer),
    	.read		(fifo_read),
    	.full		(buffer_full),
    	.half_full	(buffer_half_full),
    	.data_present	(fifo_data_present),
    	.clk		(clk));

endmodule

//
//////////////////////////////////////////////////////////////////////////////////
//
// END OF FILE UART_TX.V
//
//////////////////////////////////////////////////////////////////////////////////
//
