rhit-gardneml/Macrophthalmus/(commit log)

2023-11-02 add signalOutline.txt which is outline of signal flow
2023-11-03 step one of signal flow sims, up to bpsk modulation
2023-11-04 Ideal coherance BPSK demodulation and 200 samples downsampling to convert binary --> bpsk -->AWGN --> square --->binary
2023-11-05 Simulations added and updated, need to add PLL or Castas loop for demodulation, and need to add match filtering with RRC for signalFlow.ipynb
2023-12-15 added pcb folder
    [UHF-PCB-6layer.kicad_pcb, UHF-PCB-6layer.kicad_sch]
2023-12-15 started work on pcb, added FGPA
    [UHF-PCB-6layer.kicad_sch]
2023-12-16 added to pcb design, added all comps but mixer and microcontroller
    [UHF-PCB-6layer.kicad_sch]
2023-12-17 added microcontroller to schematic
    [UHF-PCB-6layer.kicad_sch]
2023-12-18 added XA7A to schematic
    [UHF-PCB-6layer.kicad_sch]
2023-12-20 added mixer
    [UHF-PCB-6layer.kicad_sch]
2023-12-21 added BOM to datasheets and other
    [BOM.xlsx]
2023-12-21 add start of playing with match filtering
2024-01-02 added required caps and resistors for microcontroller
    [UHF-PCB-6layer.kicad_sch]
2024-01-03 added footprints for resistors
    [UHF-PCB-6layer.kicad_sch]
2024-01-03 Microcontroller UART
2024-01-03 FPGA UART
2024-01-04 moved stuff around
    [UHF-PCB-6layer.kicad_sch]
2024-01-04 changes to pcb
2024-01-04 VCO changed to right module, still need to connect stuff and addd caps + resis + induct
    [UHF-PCB-6layer.kicad_sch]
2024-01-05 added more to VCO circuit
    [UHF-PCB-6layer.kicad_sch]
2024-01-05 added some gnds
    [UHF-PCB-6layer.kicad_sch]
2024-01-08 added connections between FPGA and micro
    [UHF-PCB-6layer.kicad_sch]
2024-01-08 maybe some edits idk
    [UHF-PCB-6layer.kicad_sch]
2024-01-13 added wire to schematic
    [UHF-PCB-6layer.kicad_sch]
2024-01-13 added 2.3MHz LPF
    [UHF-PCB-6layer.kicad_sch]
2024-01-13 added 2.3MHz LPF to input of module
    [UHF-PCB-6layer.kicad_sch]
2024-01-13 added connector for power, 3.3v, 5v, gnd, and IF signal
    [UHF-PCB-6layer.kicad_sch]
2024-01-17 added first part of tx side in schematic
    [UHF-PCB-6layer.kicad_sch]
2024-01-17 added tx/rx from MC and working on FPGA
    [UHF-PCB-6layer.kicad_sch]
2024-01-17 added LEDs and finished of the FPGA
    [UHF-PCB-6layer.kicad_sch]
2024-01-17 wdt draft added
    [UHF-PCB-6layer.kicad_sch]
2024-01-17 draft of SVC added, needs to be vetted
    [UHF-PCB-6layer.kicad_sch]
2024-01-17 added new mixer to schematic
    [UHF-PCB-6layer.kicad_sch]
2024-01-17 added footprints to all schematic symbols and added to pcb
    [UHF-PCB-6layer.kicad_pcb, UHF-PCB-6layer.kicad_sch]
2024-01-18 started layout for PCB
    [UHF-PCB-6layer.kicad_pcb]
2024-01-21 Adding the down sample with LNA. Also added up sample from 10->420 MHz
2024-01-21 Adding the tests for the ADC with random PSK signal
2024-01-23 Added in DAC code
    UART disabled
2024-01-25 added gbr files and such
    [LPF-Eval-Board-Edge_Cuts.gm1, LPF-Eval-Board-F_Cu.gtl, LPF-Eval-Board-F_Mask.gts, LPF-Eval-Board-F_Paste.gtp, LPF-Eval-Board-F_Silkscreen.gto, LPF-Eval-Board-NPTH-drl_map.gbr, LPF-Eval-Board-NPTH.drl, LPF-Eval-Board-PTH-drl_map.gbr]
2024-01-25 stuff and board things
    [LPF-Eval-Board.kicad_pcb]
2024-01-26 added bpf gbr files and eval board schematic
    [BPF-Eval-Board-Edge_Cuts.gbr, BPF-Eval-Board-F_Cu.gbr, BPF-Eval-Board-F_Mask.gbr, BPF-Eval-Board-F_Paste.gbr, BPF-Eval-Board-NPTH-drl_map.gbr, BPF-Eval-Board-NPTH.drl, BPF-Eval-Board-PTH-drl_map.gbr, BPF-Eval-Board-PTH.drl]
2024-01-26 PARTS
    I added the 1V, 1.8V, and supervisory circuit pcb eval board
    [1.8V_VoltageReg-Edge_Cuts.gbr, 1.8V_VoltageReg-F_Cu.gbr, 1.8V_VoltageReg-F_Mask.gbr, 1.8V_VoltageReg-F_Paste.gbr, 1.8V_VoltageReg-F_Silkscreen.gbr, 1.8V_VoltageReg-NPTH.drl, 1.8V_VoltageReg-PTH.drl, 1.8V_VoltageReg-job.gbrjob]
2024-01-26 Movin
    Moved eval boards to EVALBOARDS
    [1.8V_VoltageReg-Edge_Cuts.gbr, 1.8V_VoltageReg-F_Cu.gbr, 1.8V_VoltageReg-F_Mask.gbr, 1.8V_VoltageReg-F_Paste.gbr, 1.8V_VoltageReg-F_Silkscreen.gbr, 1.8V_VoltageReg-NPTH.drl, 1.8V_VoltageReg-PTH.drl, 1.8V_VoltageReg-job.gbrjob]
2024-01-26 Update BP Eval
    Added SMA to BP eval board
    [BPF-Eval-Board.kicad_pcb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]
2024-01-26 :(
    Finished eval boards
    [EMPCB.SMAFSTJ.B.HT.step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]
2024-01-29 vco pcb and girber
    [VCO-B_Cu.gbr, VCO-B_Mask.gbr, VCO-B_Paste.gbr, VCO-B_Silkscreen.gbr, VCO-Edge_Cuts.gbr, VCO-F_Cu.gbr, VCO-F_Mask.gbr, VCO-F_Paste.gbr]
2024-01-29 added gerber files for VCO
    [VCO-Edge_Cuts.gbr, VCO-F_Cu.gbr, VCO-F_Mask.gbr, VCO-F_Paste.gbr, VCO-NPTH-drl-drl_map.gbr, VCO-NPTH-drl.gbr, VCO-PTH-drl-drl_map.gbr, VCO-PTH-drl.gbr]
2024-01-29 added name
    [VCO-Edge_Cuts.gbr, VCO-F_Cu.gbr, VCO-F_Mask.gbr, VCO-F_Paste.gbr, VCO-NPTH-drl-drl_map.gbr, VCO-NPTH-drl.gbr, VCO-PTH-drl-drl_map.gbr, VCO-PTH-drl.gbr]
2024-01-29 VCO Updated
    VCO Fixed
    [VCO.kicad_pcb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]
2024-01-29 new bpf pcb
    [BPF-Eval-Board-Edge_Cuts.gbr, BPF-Eval-Board-F_Cu.gbr, BPF-Eval-Board-F_Mask.gbr, BPF-Eval-Board-F_Paste.gbr, BPF-Eval-Board-NPTH-drl-drl_map.gbr, BPF-Eval-Board-NPTH-drl.gbr, BPF-Eval-Board-PTH-drl-drl_map.gbr, BPF-Eval-Board-PTH-drl.gbr]
2024-01-30 ADC Code
    ADC code uploaded to GitHub
2024-02-10 add mixer data from 2/10 testing
    [Up_Conversion_Data_mk1.xlsx]
2024-02-10 added data from mixer and BPF
    [Data.xlsx]
2024-02-10 adc qpsk
    Actual QPSK signal screenshot
2024-02-10 Added Data rate calc
    [DataRateCalculator.xlsx]
2024-02-19 VCO
    Added change to VOLTAGECONTROLLED Oscillator
2024-03-04 useful document from 310
    [Data.xlsx]
2024-03-05 Created new board for the Low pass even though it says bandpass stuff
    [BPF-Eval-Board-F_Cu.gbr, BPF-Eval-Board-F_Mask.gbr, BPF-Eval-Board-F_Paste.gbr, NewLow-B_Cu.gbr, NewLow-B_Mask.gbr, NewLow-B_Paste.gbr, NewLow-B_Silkscreen.gbr, NewLow-Edge_Cuts.gbr]
2024-03-06 Fixed the New Low Pass Filter
    [Amplifier.kicad_pcb, Amplifier.kicad_sch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]
2024-03-07 New amplifier board
    It looks really bad
    [Amplifier-B_Cu.gbr, Amplifier-B_Mask.gbr, Amplifier-B_Paste.gbr, Amplifier-B_Silkscreen.gbr, Amplifier-Edge_Cuts.gbr, Amplifier-F_Cu.gbr, Amplifier-F_Mask.gbr, Amplifier-F_Paste.gbr]
2024-03-07 Added BPSK Digital Calculations
    [BPSK_Digital_Representation.xlsx]
2024-03-07 Alot of stuff. Eval board for amp and VCO test
    [Amplifier-B_Cu.gbr, Amplifier-B_Mask.gbr, Amplifier-B_Paste.gbr, Amplifier-B_Silkscreen.gbr, Amplifier-Edge_Cuts.gbr, Amplifier-F_Cu.gbr, Amplifier-F_Mask.gbr, Amplifier-F_Paste.gbr]
2024-03-13 Mixer board stuff
    [Mixer-B_Cu.gbr, Mixer-B_Mask.gbr, Mixer-B_Paste.gbr, Mixer-B_Silkscreen.gbr, Mixer-Edge_Cuts.gbr, Mixer-F_Cu.gbr, Mixer-F_Mask.gbr, Mixer-F_Paste.gbr]
2024-03-15 pcb grb files added for level shifter, in DC-Offset-Amp
    [DC-Offset-Amp.kicad_pcb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]
2024-03-15 added drl and such
    [DC-Offset-Amp-Edge_Cuts.gbr, DC-Offset-Amp-F_Cu.gbr, DC-Offset-Amp-NPTH-drl.gbr, DC-Offset-Amp-NPTH-drl_map.gbr, DC-Offset-Amp-NPTH.drl, DC-Offset-Amp-PTH-drl.gbr, DC-Offset-Amp-PTH-drl_map.gbr, DC-Offset-Amp-PTH.drl]
2024-03-17 Added images and adc dma code
2024-03-19 Updated all MCU code
    Added correct: ADC, DAC, WDT Code
    [adc_dma_ping_pong.c, crc_calculate_checksum.c, dac12_dma_sampletimegen.c, timx_timer_mode_periodic_sleep.c]
2024-03-19 Added excel files
    [0V_DCinput_ADC_Conversion_data.xlsx, 1V_DCinput_ADC_Conversion_data.xlsx, 2V_DCinput_ADC_Conversion_data.xlsx, BPSK_Digital_Representation - March 19.xlsx, BPSK_Digital_Representation.xlsx, DataRateCalculator - March 19.xlsx, DataRateCalculator.xlsx]
2024-03-22 power amp
    [Data.xlsx, PA-Test.xlsx]
